xiaotianandbaihui-svg/Graduation_Design/README.md

.....正在做，未完结
- 10-21：只差一丢丢，就是主控板对于滚转的控制和辅助刹车的功能了。   跳跃功能，目前还需要实测，参数未填入。   磁力计当前无法确定电机转动是否会对imu产生严重影响。一切都需等待电路板到后组装观察。
- 10-22_day：出现严重控制逻辑错误。。  其实标准做法我个人认为存在正反馈风险，对于想要一次调试成功搞不好是机毁项目凉凉。。
电路板目前不支持电流闭环控制，无法做到精确的力矩控制，这主要是因为STM32F103的接口太少了，IO口全部用光了，当时的设计目标也并非面向电流环的，如果单电压环确定可以使用，那就好，不可以，会考虑双stm32f103或者直接换f407或者f429作为驱动主控。。  ε=(´ο｀*)))唉

- 10-22_night: 今天大改电路图和代码。代码部分要进行大面积修改。emm，电路图今晚出第二版 

- 10-23：代码重构了，但我还要审核，但是呢怎么说呢。。我总觉得有些地方很不对劲，目前也暂时不知道哪里不对劲。 板子再审计几遍，打板吧。嗨哟。服了
已经神志不清了

- 10-24：初版代码已经全部完成。等待板子到手，开始上机调试....不知道效果如何，我对跳跃部分还是很慌的。  板子目前看是舵机驱动板太小了，电机驱动板又大了，但是机械结构限制也无法交换。所以板子尺寸做了电机驱动二次压缩，舵机板强行拉大了

- 10-24-night：饿啊！调参调好了，还以为是算法的问题。。。

- 10-25/10-26/10-27：  校验代码... 裁剪冗余功能
- 10-27_night： 下位机校验完成，参数标记点已经做了，整体框架已经熟悉(AI做了很多的冗余设计，生怕把我电机和舵机烧了，这很好，因为学长打比赛的时候就是没做停机保护给电机烧了的，赛场上完蛋的！我也要注意！)  我做了校验，也看不出问题，调参实战吧。   现在工作中心来到上位机和无刷电机驱动原理(我希望有更加定量的力矩分析，不只是PID那种模糊的控制概念)
- 10-28-11-02： 测试硬件电路，舵机驱动板出现1V左右的电压波动，很严重。所以，换方案了。我打算四路独立供电，用LM2596S-ADJ了，成本也比现在的低。。。服了
- 11-03： 改了第二版和第三版舵机驱动，现在确定了第三版电路为最终驱动电路。单路最大达到3A，足够一个数字舵机使用，裕量达到堵转两倍多。 希望不要出问题，明天，板子交由AI仿真校验通过后打板。。
- 11-04：跳跃和PID的时钟分离，现在放弃严格尺寸，尽可能把板子做的小一些，所以有了第四版舵机驱动板
- 11-05： 硬件电路优化布线，舵机板改为四层板，因为他要承受的峰值电流是30A—+啊QAQ。。
  代码校验通过。周末去焊接板子，最近还在学FPGA和Linux，难受咯。。。
- 11-11：这几天测试板子，崩溃了，居然因为硬件问题卡死了。开尔文走线不合格导致ADC采样值频繁触发软件的过流保护。。。现在做出改版
