xiaotianandbaihui-svg/Graduation_Design/Remote_Controller/My_Remote_Controller/README_REMOTE.md

# 轮足机器人遥控器 V1

工程：`USER/RemoteController.uvprojx`，Keil target `TOUCH`。
硬件沿用原工程 STM32F407ZG、800×480 横屏、现有 LCD DMA 与触摸驱动。

## 使用方式

- 上电进入独立主界面，选择“自动运行”或“遥控模式”；两个模式页均提供“返回主界面”按钮。
- 遥控模式使用专门页面，同时显示**目标速度/偏航**和**实际速度/偏航**；速度单位m/s，角度单位度。不显示“REMOTE CONTROL”英文标题。
- 仅在遥控页进行10秒无数据检测。未收到新回传时实际值显示“--”；超时显示“无数据传回”，收到有效回传后自动恢复。进入遥控页重新计时，主界面/自动运行页不触发此检测。
- 遥控页采用深色蓝青仪表盘：左侧显示目标速度和目标偏航，中间为实际速度表盘，右侧为实际偏航角度盘。左下角保留160×160摇杆，右下角保留120×60跳跃按钮；不显示摇杆角度刻度和底部操作提示。
- 偏航盘用蓝色指示实际Yaw、橙色标记目标Yaw；0°朝上、+90°朝右，只表示小车姿态参考系，不表示地理北方。不显示尚未接入的GPS、电量、温度或时钟数据。
- 速度表盘下方绘制轮足机器人：实际速度显示为0.00 m/s时原地转圈，非零时用道路虚线流动表现行进，负速度时道路反向流动；等待回传或超时后动画停止并变暗。动画跟随回传的实际速度，使用现有50 ms界面刷新，不增加任务。
- 按住圆盘拖动：方向决定目标绝对 Yaw，离中心越远，目标速度越大。
- 默认上方 0°、右方 +90°、下方 ±180°、左方 −90°；Yaw 编码范围为 [−180°,180°)。
- 下拉表示朝 180°方向前进，不是负速度倒车。目标 Yaw 使用小车姿态解算的参考系，并不相对于遥控器朝向。
- 松手、失去按压或切换页面：摇杆回到中心，目标速度立即归零，保留最后的目标 Yaw。这里的“停止”是目标速度为零，小车实际减速由主控完成。
- 点击“跳跃”：速度先归零，在100ms周期帧中连续发3帧jump=1，随后发jump=0；按UART成功发送推进，不等待回传。主控按0→1边沿只触发一次。发送期间按钮禁用。
- “自动运行”页按要求留白，只保留“返回主界面”按钮。主界面和自动页不周期发送目标；离开遥控页仅尝试发送一次零速度、jump=0帧，随后停发。
- 当前触摸移植只使用第一个触点，不支持同时按住摇杆并点击跳跃。

## 接线与配置

沿用现有 **USART1，PA9=TX、PA10=RX，115200、8N1**。
PA9 接 LoRa RXD，PA10 接 LoRa TXD，两端共地；模块供电按其规格连接。
本版使用透明串口传输，不包含模块型号专属配置指令、M0/M1 控制或 AUX 流控。
两端 LoRa 应预先设置兼容的信道、空中速率和传输模式。

可调整宏集中在 `USER/remote_control.h`：

| 宏 | 默认值 | 含义 |
|---|---:|---|
| `REMOTE_UART_BAUD` | 115200 | 本地串口波特率，须匹配模块 |
| `REMOTE_SEND_PERIOD_MS` | 100 | 仅遥控页，由上位机时钟决定的目标帧间隔，回传不改变节拍 |
| `REMOTE_LORA_TIMEOUT_MS` | 10000 | 仅遥控模式下，无有效回传的掉线超时 |
| 主控 `SERIAL_LORA_TIMEOUT_MS` | 1000（当前工程） | 主控无有效目标帧的掉线超时；本次保持原值 |
| `REMOTE_WHEEL_DIAMETER_M` | 0.064 | 轮径，单位 m |
| `REMOTE_MAX_SPEED_MPS` | 1.0 | 摇杆拉满的目标速度；初次调试可调小 |
| `REMOTE_STICK_DEAD_ZONE` | 0.12 | 中心死区占最大行程的比例 |
| `REMOTE_YAW_SIGN` | +1 | 改为 −1 可反转左右对应的 Yaw 正负 |
| `REMOTE_YAW_OFFSET_DEG` | 0 | 摇杆正上方对应的绝对 Yaw |
| `REMOTE_JUMP_FRAMES` | 3 | 每次跳跃重复发送的请求帧数 |

死区取 [0,1)，跳跃重复次数取 1～254。改变 Yaw 方向/零点时，只需调整上述配置宏。
速度换算：`rpm = speed_mps × 60 / (π × 0.064)`，1 m/s 约为 298.42 rpm。

表盘量程单独配置在 `USER/remote_dashboard.h` 的 `REMOTE_DASHBOARD_SPEED_MAX_MPS`，默认1.0 m/s，按实际需求设为正数（建议至少0.1）。该宏只改变表盘显示量程，不改变控制目标或限速。实际速度超量程时弧形指示到顶、数字改为橙色，数字仍保留真实值；正负号也正常显示。

进入遥控页后，下一次LoRa任务轮询先发送一帧，随后每100ms发送最新目标速度、Yaw和跳跃位。
发送时钟来自上位机FreeRTOS tick；回传只更新实测值及掉线计时，丢失或迟到不会阻止下一周期发送。
松手和跳跃在下一周期帧生效，不另外插帧。退出遥控页只尝试发送一帧零速度、jump=0，然后停发；上电主界面、主界面与自动页之间切换均不发控制帧。
UART发送失败时，遥控页等待下一100ms周期重试最新目标，不连续补发；退出帧失败则显示串口错误，下位机仍由自己的接收超时机制停速。
LoRa任务每5ms轮询；任务阻塞会推迟实际发送，恢复后不连发补齐漏掉的周期。
UART波特率不等于LoRa空中速率；要在100ms内完成一轮无线收发，模块实际往返耗时必须小于100ms并留出裕量。此版无AUX流控和帧序号，不能严格匹配迟到回传，回传也不代表跳跃动作已经执行。

## 与主控一致的 8 字节协议

| 字节 | 内容 |
|---|---|
| 0～1 | `AA 55` |
| 2～3 | 有符号 int16，小端，目标 rpm × 10 |
| 4～5 | 有符号 int16，小端，目标 Yaw(°) × 100 |
| 6 | 跳跃：0 或 1 |
| 7 | 前 7 字节累加后取低 8 位 |

`AA 55 E8 03 28 23 00 35`：100 rpm、90°、不跳跃。
`AA 55 E8 03 28 23 01 36`：100 rpm、90°、请求跳跃。
这是协议示例；界面点击跳跃时实际发送零速度。

## 实测数据回传与超时

主控收到完整有效目标帧时，由串口中断更新 `Lora_LastRxCycles`，置全局 `Serial_ControlPending` 的bit0；bit1沿用跳跃请求标记。
主控正式分支（Formal=1）在主循环调用`Serial_ProcessControl()`：消费完整有效的新目标时返回1，随后`Serial_SendFeedback()`发送一帧实测数据；没有新目标只检查超时，不主动回传。

响应固定7字节，与下发的8字节目标帧区分：

| 字节 | 内容 |
|---|---|
| 0～1 | `55 AA` |
| 2～3 | 有符号int16，小端，实际平均轮速rpm × 10 |
| 4～5 | 有符号int16，小端，实际Yaw(°) × 100 |
| 6 | 前6字节累加后的低8位 |

例：`55 AA E8 03 28 23 35` 表示实际100 rpm、Yaw 90°。
平均轮速与主控速度PID一致：`(FOOT_WHEEL_SIGN_LEFT * Speed[0] + FOOT_WHEEL_SIGN_RIGHT * Speed[1]) / 2`。
该值是轮速估算的前进速度，未补偿轮胎打滑；遥控端按64 mm轮径换算为m/s。
主控回传最近一次解算的 `angle[1]` 和最近一次CAN轮速，不等待新的传感器采样，也不消耗CAN的PID就绪标志。

遥控端中断验证完整响应后置`Lora_RxPending`；独立LoRa任务中的`RemoteControl_Poll()`取走数据并更新显示，不改变100ms发送节拍。
`RemoteControl_GetFeedback()` 按值返回完整副本，包含 `speed_mps`、`yaw_deg`、`valid`、`timed_out`。
同样，`RemoteControl_GetCommand()` 改为按值返回，不再返回内部指针；例如 `RemoteFeedback actual = RemoteControl_GetFeedback();`。
`timed_out` 是界面使用的当前掉线状态，有效回传或换页后清零；`Lora_Timeout` 仍是供其他函数消费的锁存事件，收到数据不会自动清零。
`valid` 表示当前可显示实测值。每次进入遥控页先置为0，等待进入后的新回传；收到有效数据后置1，遥控模式掉线后置0。
尚未收到新数据或超时期间，不接受非零摇杆速度和新跳跃请求。遥控页以外也不接受遥控摇杆/跳跃输入。

两端分别提供同名全局量（属于两个独立固件）：

| 变量 | 作用 |
|---|---|
| `Lora_Timeout` | 达到本端配置的无有效数据超时阈值时置1；恢复收包不会自动清零，其他代码可读取后赋0 |
| `Lora_LastRxCycles` | 收到有效完整数据时记录DWT时刻；超时处理后也设为当前时刻，开始下一轮超时检查 |

遥控端只在遥控页进行10秒检查；到期后把目标速度归零、取消待发跳跃，并继续按100ms发送零速度探测恢复。主控按自己的`SERIAL_LORA_TIMEOUT_MS`检测（当前1000ms），到期后把`target_Speed`及未执行的`Jump_Request`清零。
两端保留目标Yaw。连续离线时，各自按配置的超时间隔重新置位；其他代码清掉超时标志不会使运动自动恢复。
时间判断采用 `(uint32_t)(now - last)`，支持DWT自然回绕，不清零DWT计数器；两端主循环必须持续执行。
72 MHz时DWT约59.65秒回绕，168 MHz时约25.57秒回绕，当前10秒阈值均适用。不能停止轮询超过一个回绕周期，也不把调试暂停/深睡眠算入正常在线计时。
半帧、校验错误、串口错误和普通调试文本均不刷新有效收包时间。完整数据只在短临界区内交接，发送与浮点换算在中断外执行。

`printf/fputc` 保留。完整控制帧发送时暂停任务切换，防止其他任务的日志字节插进帧中；中断仍能响应。
不要在 ISR 中 printf。日志与控制帧共用串口，会占用 LoRa 带宽，不宜高频刷屏。
“串口发送失败”表示本机UART发送失败；UART发送成功不代表无线对端确认收到。实测回传用于确认有数据返回，不再用于放行下一次发送。
无线丢包时无法保证跳跃必达；切页也不能撤销对端已接收的跳跃。

## 文件职责与改动

| 文件 | 改动 |
|---|---|
| `USER/remote_control.c/.h`（新增） | 摇杆换算、64 mm 轮径换算、控制帧打包、发送/响应、回传解码、DWT掉线检测、跳跃脉冲 |
| `USER/remote_ui.c/.h` | 主界面、独立遥控页、自动运行页、圆盘触控、跳跃按钮、页面扩展入口；遥控数据显示交给仪表盘组件 |
| `USER/remote_dashboard.c/.h`（新增） | 目标/实际数据显示、速度表盘、偏航角度盘、回传状态和轮足机器人动画；原生LVGL绘制，无图片帧缓存 |
| `USER/remote_font.c/.h` | 中文/ASCII 20px、24px字形子集，以及48px、72px纯数字字形，减少字体占用 |
| `USER/main.c` | 初始化硬件和共享数据，调用统一任务创建入口，然后启动调度器 |
| `USER/app_tasks.c/.h` | 集中放GUI/LoRa任务函数、按表创建任务的函数及tick hook |
| `USER/task_config.c/.h` | 独立声明任务配置结构体，定义任务配置表和表长度 |
| `SYSTEM/usart/usart.c/.h` | 新增完整二进制帧发送和超时；保留 printf；接收中断移除不适用的任务临界区调用，接收中断解析并缓存LoRa实测回传 |
| `SYSTEM/delay/delay.c` | 恢复 SysTick HCLK/8 轮询阻塞延时；任务中挂起调度，退出配对恢复；累计回绕并分段避免乘法溢出 |
| `FreeRTOS/FreeRTOSConfig.h` | 保持 SysTick HCLK/8 和 1 ms tick；开启 tick hook，并允许查询调度器状态 |
| `MIDDLEWARE/LVGL/GUI/lvgl/lv_conf.h` | 使用 lv_tick_inc；本次保持配置不变，仪表盘使用专用数字字体子集 |
| `MIDDLEWARE/LVGL/GUI/lvgl/examples/porting/lv_port_disp_template.c` | 双绘图缓冲由各 20 行缩为各 10 行，节省约 32 KB RAM；修正 static 声明 |
| 同目录 `lv_port_disp_template.h`、`lv_port_indev_template.h` | 启用模板中被 `#if 0` 屏蔽的接口声明 |
| `USER/RemoteController.uvprojx` | 加入新文件，FreeRTOS 引用改为工程内已有副本 |

`delay_init()` 只在调度器启动前调用，启动前不打开 SysTick 中断；FreeRTOS启动后接管为 1 ms 中断，继续使用同一八分频时钟。
`delay_us()` / `delay_ms()` 均为阻塞忙等，LCD、触摸、软件 I²C 等现有调用继续使用。
延时过程中中断仍可响应；不要从ISR调用，也不要在调用期间改变SysTick配置。中断占用时间会影响延时精度。
`delay_ms(u16)` 最大参数为65535 ms；更长时间可分次调用，或用 `delay_us(u32)`，例如 `delay_us(120000000u)` 为至少120 s的忙等。
串口20ms发送超时及LoRa掉线检测使用DWT，由`uart_init()`独立启用；100ms发送节拍使用FreeRTOS tick；`printf`保留。
GUI主循环的 `vTaskDelay(5 ms)` 负责让出CPU，继续保留，不用于外设微秒时序。

两个应用任务分别运行，函数集中在 `app_tasks.c`；配置集中在 `task_config.c`，结构体声明在 `task_config.h`：

| 任务 | 函数 | 栈大小 | 优先级 | 间隔 | 职责 |
|---|---|---:|---:|---:|---|
| GUI | `App_GuiTask` | 2048字=8KB | 2 | 每轮结束等待5 ms | 初始化显示/触摸、处理LVGL、显示目标/回传/状态 |
| LoRa | `App_LoraTask` | 512字=2KB | 3 | 每5 ms轮询 | 遥控页100ms周期发送、回传处理、退出单帧停速及遥控页10秒掉线检测 |

FreeRTOS还会创建自身的Idle任务。配置表统一保存名称、入口函数指针、栈深度、优先级、间隔和任务句柄；任务参数自动传入对应表项的地址。
栈深度单位是 `StackType_t`，本机每字4字节；优先级数字越大越高，须小于 `configMAX_PRIORITIES`。间隔必须至少1个tick。
新增任务时，在 `app_tasks.c/.h` 添加函数/声明，在 `task_config.c` 增加一行即可；创建循环按表长度自动处理。
GUI读取共享数据时获取完整副本；修改目标及协议状态时短暂暂停任务切换，UART接收中断仍能响应。LoRa任务不调用LVGL，UART发送结果只通过一个对齐标量交给GUI显示。
LoRa任务使用FreeRTOS tick独立计时，不依赖LVGL刷新。tick hook只调用允许在中断使用的 `lv_tick_inc`；LCD DMA中断仍只通知刷新完成。
原SysTick阻塞延时、UART整帧发送保护及printf均保留：这些既有函数中的调度暂停仍会暂时推迟任务切换，拆成多任务不消除这部分延迟。
新增页面：在 `remote_ui.h` 扩展 `RemotePage`，在 `remote_ui.c` 增加创建函数并加入 `page_create` 表，再用 `RemoteUi_ShowPage()` 切换。

## 验证与联调事项

已在电脑上使用本工程真实 LVGL 源码绘制并检查三个页面，模拟拖动、越界拖动、松手、跳跃、换页和串口失败提示。
控制逻辑测试覆盖完整 360°方向、死区、速度换算、字节格式、发送时钟回绕和失败重试。
也用主控当前的 `Hardware/Serial.c` 验证了解码兼容性。
Keil 完整重编译：0 Error、30 Warning；30 条警告均位于原有 LVGL 库，本次应用代码没有编译警告。
原版链接 RAM 占用约 95.3 KiB，位于 128 KiB SRAM 范围内；当前布局的具体占用以本次 Keil 构建输出为准。
固件生成于 `OBJ/TOUCH.hex`。这些检查不代替实板触摸、LCD DMA 和无线链路测试。

本次两端互传验证覆盖：实际编解码互通、正负轮速/Yaw、半帧/错包/调试文字、UART错误、等待响应时不连发、丢响应重试最新目标、跳跃重试不重复触发、10秒边界与重复超时、72/168 MHz下DWT回绕及恢复连接。两端printf后端保持原样。

主控当前仍为 `Formal == 2` 调试分支：CAN初始化被注释，轮速回传因此为初始值；高频姿态printf也仍保留。正式无线联调时，需要使用已开启CAN轮速反馈的运行配置，并避免调试日志持续占满同一LoRa串口。跳跃暂停CAN时，回传轮速为暂停前最近一帧，不是新的轮速采样。
Keil检查：主控正式分支0错误0警告，调试分支0错误3个原有未使用函数警告；遥控端0错误30个原有LVGL警告。尚未进行实物LoRa联调。

## 2026-10-30 多任务与回传显示验证

已验证配置表创建/失败路径、GUI与通信任务职责、共享数据副本与嵌套调度保护；原LoRa协议、跳跃重试和DWT回绕测试继续通过。
使用工程真实LVGL进行界面绘制和触摸模拟，覆盖主界面/自动页不报10秒超时、遥控页重计时、实测正负值及极值不越界、无数据提示、外部清除事件标志不掩盖当前掉线、恢复回传及页面切换。
Keil完整重编译0错误，30条警告仍来自原LVGL库；新增应用代码无编译警告。尚未进行实板任务栈余量与LoRa联调。

## 2026-10-30 仪表盘与机器人动画

使用工程真实LVGL源码在电脑上绘制检查，验证目标/实际正负数、超量程数字、原地旋转、行进道路流动、无数据时动画停止，以及摇杆松手回中、跳跃、换页、仅遥控模式超时与恢复。
本次只改界面组件、字体、工程文件列表和本说明；LoRa协议、两任务配置、阻塞延时与printf保持原样。电脑渲染预览并非实板录像，实板刷新速度与触摸体验仍需烧录验证。

## 2026-11-04 遥控页100ms主动发送

本节和上文当前用法取代旧验证记录中的“等响应/500ms重试”流程。
仅修改USER/remote_control.c、USER/remote_control.h及本说明。沿用现有界面切页接口、任务配置、8字节目标/7字节回传协议和printf。
主控当前选择Formal=4串口调试分支，未执行完整收包后的正常回传调用；正式联调须选择Formal=1或由用户在调试流程中接入该调用。本次没有切换主控运行分支，也没有修改主控源文件。
主机测试通过：非遥控页静默、无/迟到响应不改变100ms发送、松手与跳跃在周期帧生效、退出单帧停速、UART失败限速重试、与当前主控Serial.c编解码互通、10秒超时、毫秒/DWT回绕及任务切换。
遥控工程完整编译0错误，30条警告均来自原有LVGL代码。尚未实测LoRa空中往返时间。
