xiaotianandbaihui-svg/Graduation_Design/固件代码(非KEIL工程)/BDS3620_TLE5012B_六步换相/验证记录.md

# 验证记录

日期：2026-10-01。目标：STM32F103C8T6，STM32F10x标准库，Cortex-M3，64KB Flash / 20KB RAM。

## 软件逻辑测试

执行 `tests/validate.ps1`，主机GCC采用 `-std=c99 -O2 -Wall -Wextra -Werror` 编译 `motor.c`、`tle5012b.c` 和模拟硬件测试。

结果：全部断言通过。

```text
PASS: CRC/status; 65536 signed-angle cases; 42 sectors/rev; dual-motor stop/faults; timing/wrap; calibration +/- and stalled rotor.
```

覆盖内容：

- CRC-8/SAE-J1850标准测试字符串`123456789`，结果0x4B；数据损坏和安全字错误检查。
- 编码器正、反两个方向，每个方向遍历全部32768个角度计数。
- 每机械圈42次扇区变化；正反向矢量相差180电角度；正向矢量领先60～120电角度。
- 编码器高位屏蔽、角度比例、跨机械零点、DWT计数器回绕。
- 未标定拒绝启动、双路运行、单路停止、故障时双路关闭、故障恢复后不自动启动。
- CRC错误、总线错误、运行超时、模拟驱动器故障和持续复位状态。
- 两种编码器方向的模拟标定成功，以及模拟转子不动时标定失败。

这里模拟了硬件端口、时间推进和电机对齐响应，**没有模拟真实绕组电流、磁场误差或MOS开关动态**。硬件定时器和中断的真实波形不由这些主机测试证明。

## ARM标准库编译与链接

工具：MDK Plus 5.39，Arm Compiler for Embedded 6.21。

依赖：Keil STM32F1xx_DFP 2.4.1中的设备头文件、STM32F10x SPL源文件、系统时钟源文件和中容量启动文件；CMSIS 5.9.0。

本例4个C源文件及所需标准库源文件使用Cortex-M3目标、`-O2 -Wall -Wextra -Werror`编译。分别链接默认只读角度分支和启用标定/运行分支，均通过。

| 示例 | 链接器报告的ROM | RW+ZI，含启动文件预留堆栈 | 结果 |
|---|---:|---:|---|
| 默认只读角度 | 8892字节 | 1728字节 | 通过 |
| 启用标定和运行分支 | 10348字节 | 1736字节 | 通过 |

链接布局限制为64KB Flash、20KB RAM。上表是本示例独立构建的数值，不包含你原工程的其他模块，也不等于对运行时最大调用栈的实测。

C代码编译没有警告。Keil自带启动汇编文件构建时出现一条工具提示：`A1950W: The legacy armasm assembler is deprecated`；它提示汇编工具已弃用，不是固件代码错误。两次链接成功。

最终构建输出位于本机临时目录：

`C:/Users/lenovo/AppData/Local/Temp/bds3620_validate_8c60713967fb43baa3d1564ffb9ef83c`

其中 `motor.map`、`motor_with_calibration.map` 是对应链接报告。脚本可重现构建；无需依赖临时目录长期存在。未执行烧录。

## 尚未实测

- 成品编码器板的电平和MOSI/MISO内部接法、双模块总线释放行为。
- SPI时序与CRC在实物上的连续读取、实际程序执行时间。
- 三相接线、门极切换波形、对齐占空比和电流、最大可运行转速。
- 板上nFAULT触发、更新超时处理与实际功率级停止行为。

因此交付状态为：**源码、编译链接和软件逻辑测试完成，硬件实测未完成。**
