xiaotianandbaihui-svg/Graduation_Design/固件代码(非KEIL工程)/LQR准备--状态方程/LQR计算/使用说明.md

打开 `run_wheel_leg_lqr.m`，把NaN替换为实际机械参数，填写Q、R后运行，即可显示K。

这是独立脚本，只调用MATLAB的lqr（需要Control System Toolbox），不依赖其他自定义函数。计算连续时间LQR，状态顺序为[位移、速度、倾角、倾角速度]，角度使用弧度；输入tau=-K*X是两轮力矩之和，单位N*m。
