xiaotianandbaihui-svg/Graduation_Design/Remote_Controller/APB_BUS_Learn/image.png

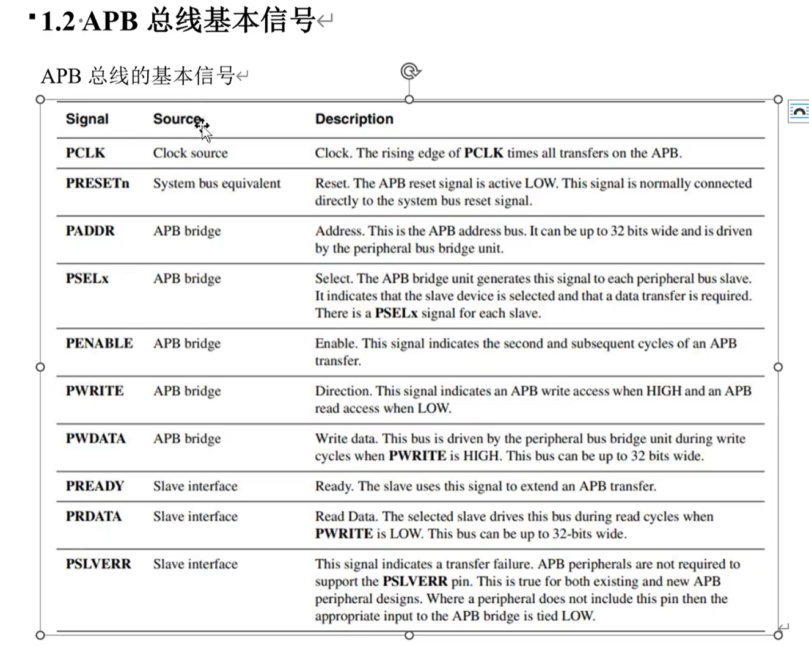
Remote_Controller/APB_BUS_Learn/image.png
