xiaotianandbaihui-svg/Graduation_Design/固件代码(非KEIL工程)/LQR准备--状态方程/image.png

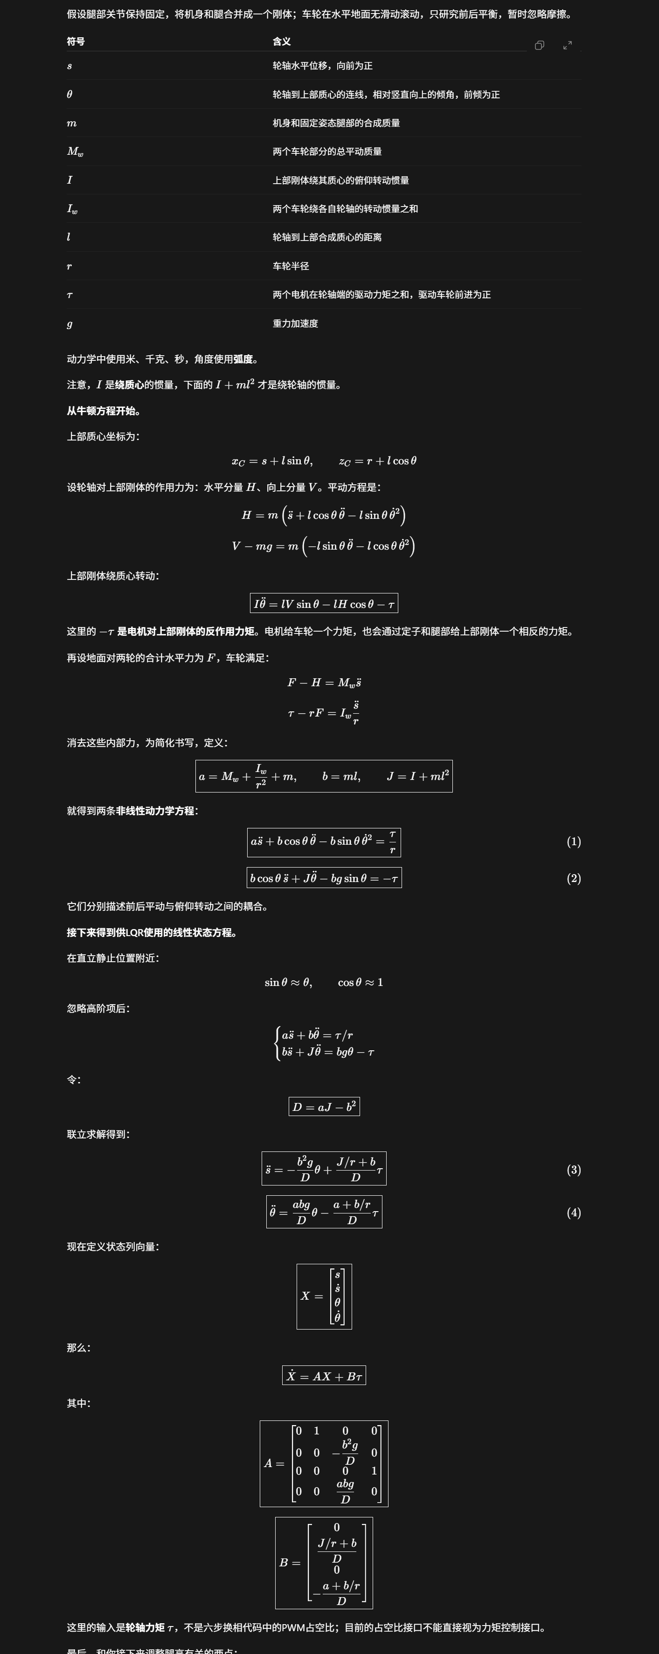
固件代码(非KEIL工程)/LQR准备--状态方程/image.png
