xiaotianandbaihui-svg/Graduation_Design/固件代码(非KEIL工程)/五连杆逆运动学/两根连杆_两种姿态.png

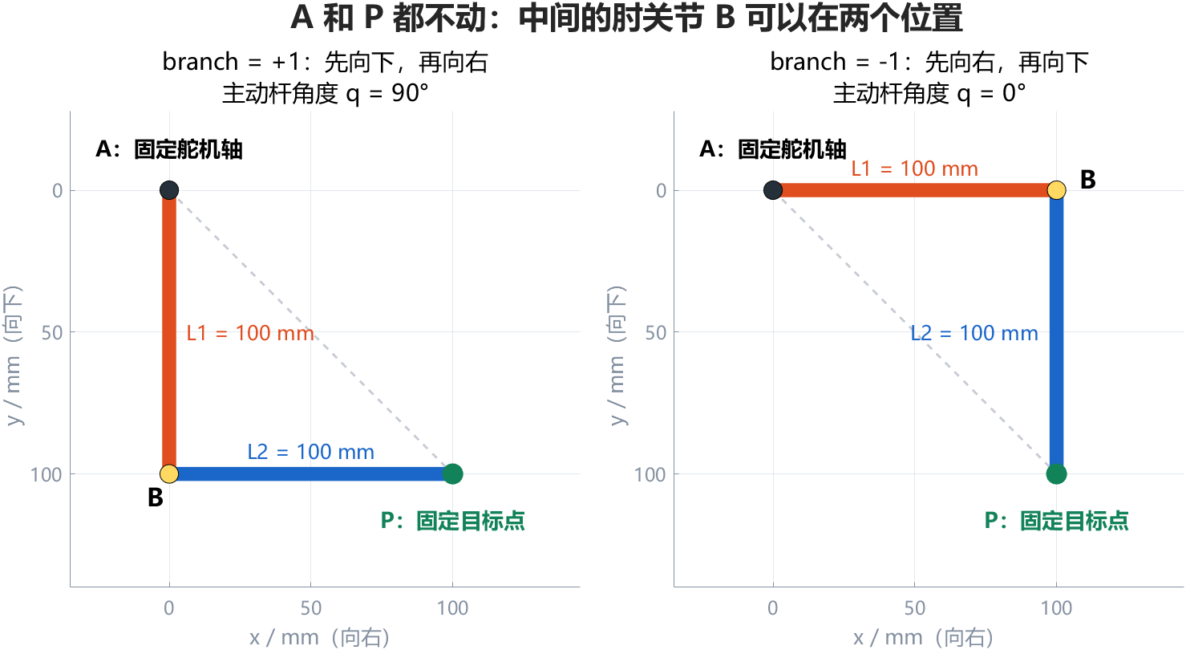
固件代码(非KEIL工程)/五连杆逆运动学/两根连杆_两种姿态.png
