xiaotianandbaihui-svg/Graduation_Design/固件代码(非KEIL工程)/五连杆逆运动学/五连杆_branch1对比.png

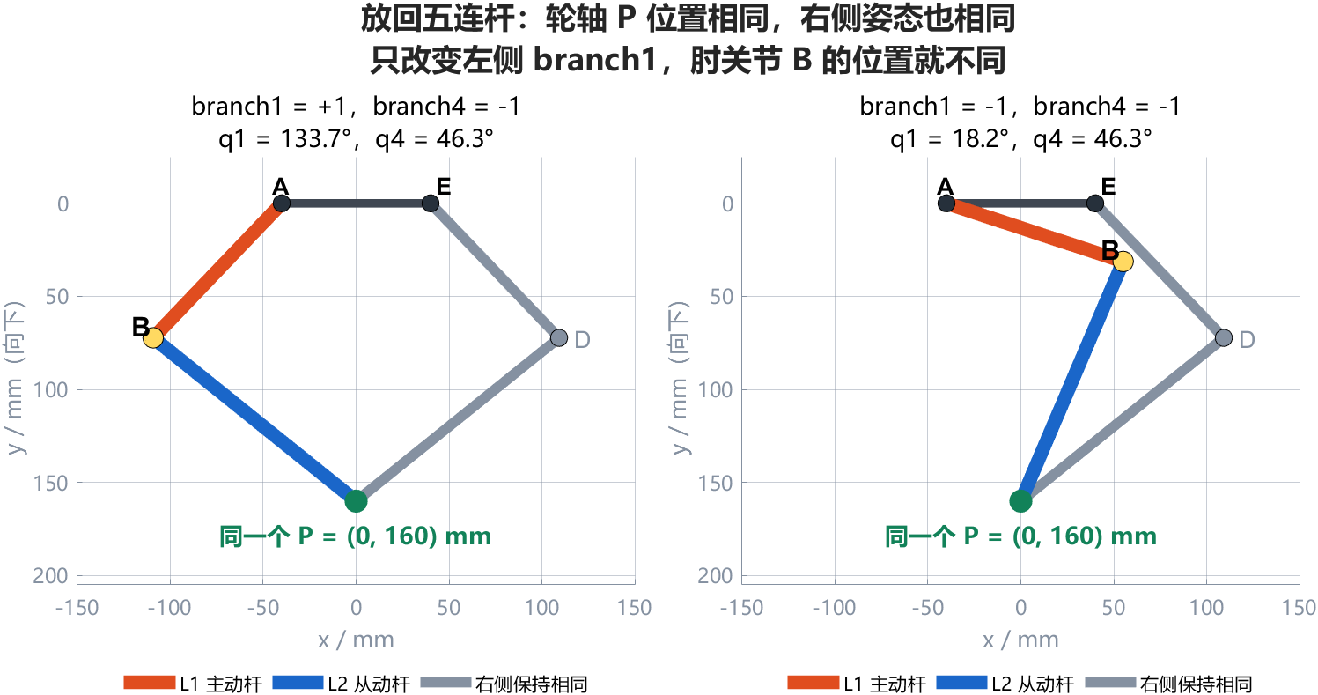
固件代码(非KEIL工程)/五连杆逆运动学/五连杆_branch1对比.png
