xiaotianandbaihui-svg/Graduation_Design/电机驱动BOM(器件可以找相似平替).xlsx

No. | Quantity | Comment | Designator | Footprint | Value | Manufacturer Part | Manufacturer | Supplier Part | Supplier
1 | 2 | 1uF/25V | C1,C20 | C0805 | 1uF/25V | CL21B105KBFNNNE | SAMSUNG(三星) |  | LCSC
2 | 1 | 10uF | C2 | C0603 |  | 10uF |  | C9900012833 | LCSC
3 | 1 | 0.1uF | C3 | C0603 |  | 0.1uF |  | C9900012833 | LCSC
4 | 5 | 100nF | C4,C23,C24,C25,C27 | C0805 | 100nF | CL21B104KBCNNWC | SAMSUNG(三星) | C3901446 | LCSC
5 | 5 | 0.1uF/25V | C5,C11,C14,C15,C28 | C0603 |  | 0.1uF/25V |  | C9900012833 | LCSC
6 | 2 | >10uF/25V | C6,C8 | C0603 |  | >10uF/25V |  | C9900012833 | LCSC
7 | 2 | 1uF/10V | C9,C10 | C0603 |  | 1uF/10V |  | C9900012833 | LCSC
8 | 2 | 100nF | C12,C13 | C0603 | 100nF | ST18B104K500CT | Walsin(华新科) | C2918557 | LCSC
9 | 1 | 47nF | C16 | C0805 | 47nF | C0805C473K2RAC7800 | KEMET(基美) | C141149 | LCSC
10 | 2 | 22pF | C17,C26 | C0603 | 22pF | C0603C220J2GAC7867 | KEMET(基美) | C140958 | LCSC
11 | 2 | 47nF/50V | C21,C22 | C0402 | 47nF/50V | 0402X473K250NT | FH(风华) |  | LCSC
12 | 1 | HDR1X2 | CAN | HDR-TH_2P-P2.54-V-M-1 |  | HDR1X2 |  | C9900014921 | LCSC
13 | 13 | CSD18540Q5BT | Q1,Q2,Q3,Q4,Q5,Q6,Q7,Q8,Q9,Q10,Q11,Q12,Q13 | PDFNWB-8L_L6.0-W5.0-P1.27-BL-EP |  | CSD18540Q5BT | TI(德州仪器) | C2863985 | LCSC
14 | 2 | 75kΩ | R1,R2 | R0603 | 75kΩ | ERJ3GEYJ753V | PANASONIC(松下) | C403533 | LCSC
15 | 6 | 10kΩ | R3,R4,R6,R10,R11,R13 | R0204 | 10kΩ | MELF-MFR02041/4WS10KΩFT50 | Thunder Component(帝谷) | C265133 | LCSC
16 | 1 | 1kΩ | R5 | R1206 | 1kΩ | MELF-MFR02041/4WS1KΩFT50 | Thunder Component(帝谷) | C265216 | LCSC
17 | 2 | 100kΩ | R7,R8 | R0402 | 100kΩ | RE0402FRE07100KL | YAGEO(国巨) | C852071 | LCSC
18 | 2 | 60Ω | R9,R12 | R0402 | 60Ω | M55342H11B60D0RWI | VISHAY(威世) | C4323948 | LCSC
19 | 2 | 47kΩ/0Ω | R15,R16 | R0603 | 47kΩ/0Ω | CR0603JA0473G | LIZ(丽智电子) |  | LCSC
20 | 2 | XH2.54-4PIN | STLink,串口调试接口 | CONN-TH_XH2.54-4 |  | XH2.54-4PIN |  | C9900014913 | LCSC
21 | 2 | DRV8323HRTAT | U1,U2 | WQFN-40_L6.0-W6.0-P0.50-TL-EP4.2 |  | DRV8323HRTAT | TI(德州仪器) | C2150673 | LCSC
22 | 1 | LM7805-5V | U3 | TO-252-3L_L6.6-W6.1-P4.60-LS9.5-BR-CW |  | LM7805-5V |  | C9900015885 | LCSC
23 | 1 | 220nF/25V | U4 | C1206 | 220nF/25V | CA45A-A-35V-0.22UF-K | XY(振华新云) |  | LCSC
24 | 1 | AMS1117-3.3 | U5 | SOT-223-3_L6.5-W3.4-P2.30-LS7.0-BR |  | AMS1117-3.3 | Advanced Monolithic Systems | C6186 | LCSC
25 | 2 | 220uF | U6,U7 | CAP-SMD_BD6.3-L6.6-W6.6-LS7.2-FD-1 |  | 220uF |  | C9900014617 | LCSC
26 | 1 | STM32F103C8T6 | U8 | LQFP-48_L7.0-W7.0-P0.50-LS9.0-BL |  | STM32F103C8T6 | ST(意法半导体) | C8734 | LCSC
27 | 6 | 5mΩ | U9,U10,U11,U12,U13,U14 | R1206 | 5mΩ | ZLR06-1-5F | yezhan(业展) | C5200077 | LCSC
28 | 1 | SS12D00G2 | U15 | SW-TH_SS12D00G2 |  | SS12D00G2 | YIZHI(逸致) | C50377146 | LCSC
29 | 1 | 电源灯 | U16 | LED0805-RD_GREEN |  | 电源灯 |  | C9900005753 | LCSC
30 | 1 | TJA1050T | U18 | SOIC-8_L4.9-W3.9-P1.27-LS6.0-BL |  | TJA1050T | NXP(恩智浦) | C23069945 | LCSC
31 | 1 | 3.81_2P接线端子 | U19 | CONN-TH_3.81_2P |  | 3.81_2P接线端子 |  | C2895155 | LCSC
32 | 1 | 8MHz | X1 | CRYSTAL-SMD_L3.2-W2.5_3225-8MHZ | 8MHz | X22EL89COI-111YLC-8M | YXC(扬兴晶振) | C42448903 | LCSC
33 | 1 | SW_PB_ESW_1 | 复位 | KEY-SMD_L6.1-W3.8-LS8.0 |  | SW_PB_ESW_1 |  | C9900009156 | LCSC
34 | 2 | ZH1.5-WF-6P | 编码器1,编码器2 | CONN-SMD_6P-P1.50_XUNPU_WAFER-ZH1.5-6PWB |  | ZH1.5-WF-6P |  | C9900021899 | LCSC
