xiaotianandbaihui-svg/Graduation_Design/舵机驱动BOM((器件可以找相似平替)).xlsx

No. | Quantity | Comment | Designator | Footprint | Value | Manufacturer Part | Manufacturer | Supplier Part | Supplier
1 | 1 | 6.8nF/50V | C1 | C0603 | 6.8nF/50V | C1608X8R2A682K080AE | TDK |  | LCSC
2 | 1 | 330nF/50V | C2 | C0402 | 330nF/50V | CL05B103KO5NNWC | SAMSUNG(三星) |  | LCSC
3 | 1 | 680pF/50V | C3 | C0402 | 680pF/50V | UMK105CH750JV-F | TAIYO YUDEN(太诱) |  | LCSC
4 | 1 | 220nF/16V/陶瓷 | C4 | C0603 | 220nF/16V/陶瓷 | CC0603KRX7R9BB104 | YAGEO(国巨) |  | LCSC
5 | 1 | 220nF/16V/陶瓷 | C5 | C0805 | 220nF/16V/陶瓷 | CC0805KRX7R9BB221 | YAGEO(国巨) |  | LCSC
6 | 1 | 2.2uF/16V/陶瓷 | C6 | C0805 | 2.2uF/16V/陶瓷 | CC0805KRX7R9BB221 | YAGEO(国巨) |  | LCSC
7 | 1 | 22pF/50V | C7 | C0402 | 22pF/50V | GCM1555C1H820JA16J | muRata(村田) |  | LCSC
8 | 6 | 22uF/25V/陶瓷 | C8,C9,C10,C11,C13,C14 | C0805 | 22uF/25V/陶瓷 | CC0805KRX7R9BB221 | YAGEO(国巨) |  | LCSC
9 | 2 | 100nF | C12,C15 | C0805 | 100nF | CC0805KRX7R9BB104 | YAGEO(国巨) | C49678 | LCSC
10 | 1 | LAIL-PZ2.54-4P-L | H1 | CONN-TH_LAIL-PZ2.54-4P-L |  | LAIL-PZ2.54-4P-L | LAILAN(莱联) | C54950602 | LCSC
11 | 1 | 6.8uH/14A对应20℃温升；18.5A对应40℃温升 | L1 | IND-SMD_L11.3-W10.0_XAL1010-332ME | 6.8uH/14A对应20℃温升；18.5A对应40℃温升 | XAL1010-682MED | Coilcraft(线艺) |  | LCSC
12 | 3 | CSD18540Q5BT | Q1,Q2,Q3 | PDFNWB-8L_L6.0-W5.0-P1.27-BL-EP |  | CSD18540Q5BT | TI(德州仪器) | C2863985 | LCSC
13 | 1 | 16.5kΩ | R1 | R0805 | 16.5kΩ | AC0805FR-0716K5L | YAGEO(国巨) | C228333 | LCSC
14 | 1 | 680Ω | R2 | R0805 | 680Ω | WR08X681 JTL |  | C384073 | LCSC
15 | 1 | 2K | R3 | R0603 | 2K
16 | 1 | 1.5kΩ | R4 | R0603 | 1.5kΩ | RN731JTTD1502B25 | KOA |  | LCSC
17 | 1 | 33.2kΩ | R5 | R0402 | 33.2kΩ | PTFR0402B33K2N9 | RESI(开步睿思) | C2692992 | LCSC
18 | 1 | 1kΩ | R6 | R0805 | 1kΩ | ESR10EZPF71R5 | ROHM(罗姆) |  | LCSC
19 | 2 | 4.7Ω | R7,R8 | R0805 | 4.7Ω | CR0805F84R70G | LIZ(丽智电子) | C101766 | LCSC
20 | 1 | 10mΩ | R10 | R1206 | 10mΩ | RE1206F1R010 | JIERR(捷而瑞) | C46961737 | LCSC
21 | 1 | LM5146RGYR | U1 | VQFN-20_L4.5-W3.5-P0.50-BL-EP |  | LM5146RGYR | TI(德州仪器) | C3188679 | LCSC
22 | 1 | 7.68kΩ | U2 | R0603 | 7.68kΩ | ERA-3AEB7681V | PANASONIC(松下) | C2074630 | LCSC
23 | 1 | 49.9kΩ | U3 | R1206 | 49.9kΩ | CR1206F44992G | LIZ(丽智电子) | C102209 | LCSC
24 | 1 | 20kΩ | U4 | R0603 | 20kΩ | MCR03ERTF2002 |  | C224673 | LCSC
25 | 1 | SS12D00G2 | U5 | SW-TH_SS12D00G2 |  | SS12D00G2 | YIZHI(逸致) | C50377146 | LCSC
26 | 3 | 3.81_2P接线端子 | U6,U7,U19 | CONN-TH_3.81_2P |  | 3.81_2P接线端子 |  | C2895155 | LCSC
27 | 4 | TXM_3 | U8,U9,U10,U11 | HDR-TH_3P-P2.54-V-M-A |  | TXM_3 |  | C9900014923 | LCSC
28 | 1 | 220uF/25V-SMT | U12 | CAP-SMD_BD8.0-L8.3-W8.3-LS9.3-FD-1 |  | 220uF/25V-SMT |  | C9900017672 | LCSC
29 | 2 | 100kΩ | U13,U16 | R0603 | 100kΩ | MCR03ERTF2002 |  |  | LCSC
30 | 2 | 16V470UF | U14,U15 | CAP-SMD_BD8.0-L8.3-W8.3-LS9.3-FD |  | 16V470UF |  | C9900014916 | LCSC
