xiaotianandbaihui-svg/Graduation_Design/电机驱动4.0.xlsx

No. | Quantity | Comment | Designator | Footprint | Value | Manufacturer Part | Manufacturer | Supplier Part | Supplier
1 | 8 | 0.1uF/25V | C1,C4,C10,C11,C17,C18,C23,C28 | C0603 |  | 0.1uF/25V |  | C9900012833 | LCSC
2 | 8 | 22uF/25V/陶瓷 | C2,C5,C9,C12,C13,C16,C19,C22 | C0805 | 22uF/25V/陶瓷 | CC0805KRX7R9BB221 | YAGEO(国巨) |  | LCSC
3 | 8 | 10uF | C3,C6,C7,C8,C14,C15,C20,C21 | C0603 |  | 10uF |  | C9900012833 | LCSC
4 | 1 | LAIL-PZ2.54-4P-L | H1 | CONN-TH_LAIL-PZ2.54-4P-L |  | LAIL-PZ2.54-4P-L | LAILAN(莱联) | C54950602 | LCSC
5 | 1 | CSD18540Q5BT | Q3 | PDFNWB-8L_L6.0-W5.0-P1.27-BL-EP |  | CSD18540Q5BT | TI(德州仪器) | C2863985 | LCSC
6 | 4 | 8.2kΩ | R1,R4,R7,R10 | R0805 | 8.2kΩ | HPCR0805F8K20K9 | RESI(开步睿思) | C365352 | LCSC
7 | 4 | 49.9Ω | R2,R5,R8,R11 | R0603 | 49.9Ω | RNCS0603BKE49R9 | SEI(Stackpole Electronics Inc.) | C346679 | LCSC
8 | 4 | 560Ω | R3,R6,R9,R12 | R0805 | 560Ω | CR0805F85600G | LIZ(丽智电子) | C101789 | LCSC
9 | 4 | TPS54302DDCR | U1,U4,U11,U21 | TSOT-23-6_L2.9-W1.6-P0.95-LS2.8-BR |  | TPS54302DDCR |  | C316459 | LCSC
10 | 4 | 82pF | U2,U8,U12,U22 | C0603 | 82pF | 06035A820J4T2A | Kyocera AVX | C2182739 | LCSC
11 | 4 | 10uH | U3,U9,U14,U23 | IND-SMD_L5.7-W5.1 |  | 10uH |  | C9900015114 | LCSC
12 | 1 | SS12D00G2 | U5 | SW-TH_SS12D00G2 |  | SS12D00G2 | YIZHI(逸致) | C50377146 | LCSC
13 | 4 | 100kΩ | U10,U13,U15,U24 | R0603 | 100kΩ | MCR03ERTF2002 |  |  | LCSC
14 | 4 | TXM_3 | U16,U17,U18,U20 | HDR-TH_3P-P2.54-V-M-A |  | TXM_3 |  | C9900014923 | LCSC
15 | 3 | 3.81_2P接线端子 | 主控供电,电驱供电,舵机供电 | CONN-TH_3.81_2P |  | 3.81_2P接线端子 |  | C2895155 | LCSC
