xiaotianandbaihui-svg/Graduation_Design/Motor_Board.SLDPRT

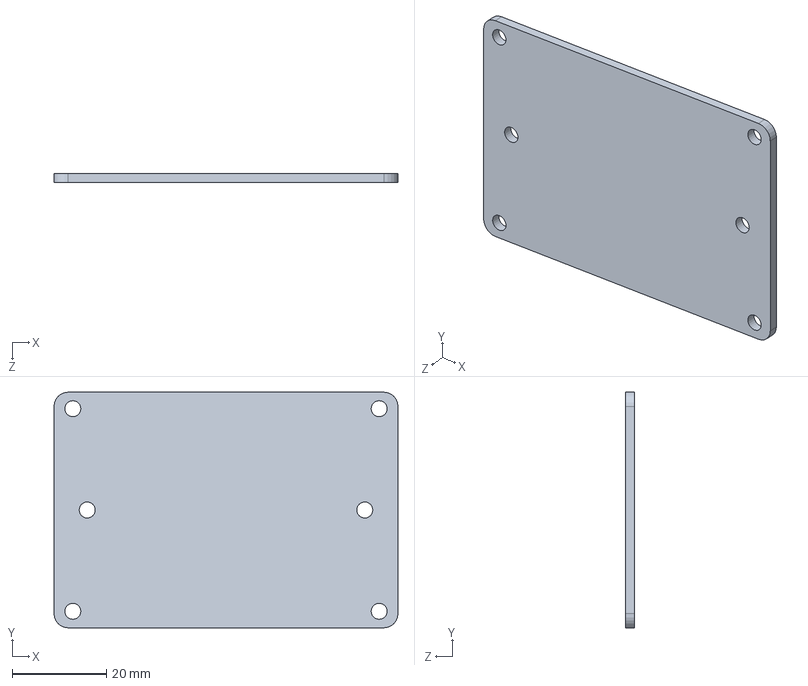
[picture p6: CAD file, 2026-11-01]
Motor_Board.SLDPRT
73.0 x 50.0 x 2.00 mm
