xiaotianandbaihui-svg/Graduation_Design/Battery_Room.SLDPRT

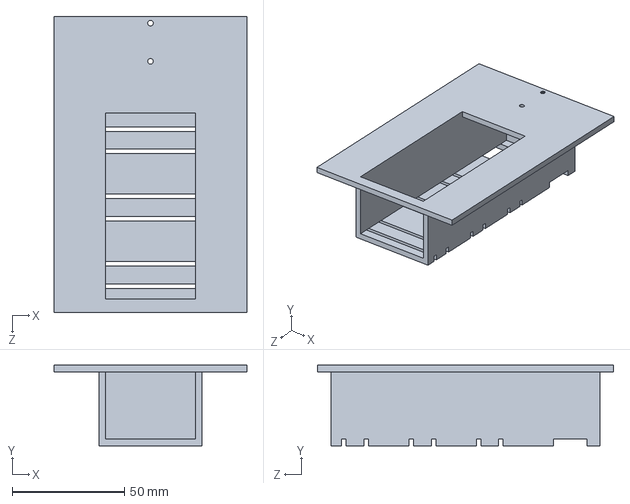
[picture p7: CAD file, 2026-10-14]
Battery_Room.SLDPRT
86.0 x 36.0 x 132.0 mm
