xiaotianandbaihui-svg/Graduation_Design/(list of files, cad)

Other CAD files:
Motor_Board.STL
