xiaotianandbaihui-svg/Graduation_Design/Central_Controller_KEIL/User/main.c

#include "stm32f10x.h"
#include "Serial.h"
#include "mpu6500_spi.h"
#include <stdio.h>
#include <math.h>
#include "can_pitch.h"
#include "zf_device_imu963ra.h"
#include "IMU.h"
#include "leg_ik.h"
#include "servo.h"
#include "Delay.h"
#include "balance_pid.h"
#include "jump.h"

#define IMU_PERIOD_MS  1u       /* TIM2时基，单位ms */
#define IMU_ATTITUDE_PERIOD_MS 20u /* 完整姿态采样/解算周期，独立于FOOT_PID_PERIOD_MS，这里我们只是给的一样，但是完全可以不一样 */
#define IMU_CYCLE_NOW (*(volatile uint32_t *)0xE0001004u) /* DWT周期计数，不清零 */
#if FOOT_PID_PERIOD_MS < 1u || IMU_ATTITUDE_PERIOD_MS < 1u
#error Control_period_must_be_positive
#endif

#if IMU_PERIOD_MS < 1u || IMU_PERIOD_MS > 50u
#error IMU_PERIOD_MS_must_be_1_to_50
#endif

/*转化前的原始数据*/
extern int16_t imu963ra_gyro_x, imu963ra_gyro_y, imu963ra_gyro_z ;       // 三轴陀螺仪数据      GYRO (陀螺仪)
extern int16_t imu963ra_acc_x,  imu963ra_acc_y,  imu963ra_acc_z;        // 三轴加速度计数据     ACC  (accelerometer 加速度计)
extern int16_t imu963ra_mag_x,  imu963ra_mag_y,  imu963ra_mag_z;        // 三轴磁力计数据      MAG  (magnetometer 磁力计)

/*滤波后的的原始数据*/
float imu963ra_gyro_x_out, imu963ra_gyro_y_out, imu963ra_gyro_z_out ;       // 三轴陀螺仪数据      GYRO (陀螺仪)
float imu963ra_acc_x_out,  imu963ra_acc_y_out,  imu963ra_acc_z_out;        // 三轴加速度计数据     ACC  (accelerometer 加速度计)
float imu963ra_mag_x_out,  imu963ra_mag_y_out,  imu963ra_mag_z_out;        // 三轴磁力计数据      MAG  (magnetometer 磁力计)
uint8_t flag_filter_run=0;//滤波器首次启动，用于去除缓拟合的
float alpha_for_acc=0.45,alpha_for_gyro=0.4,alpha_for_mag=1;
/*转化后的数据*/
float imu963ra_gyro_x_transition, imu963ra_gyro_y_transition, imu963ra_gyro_z_transition;
float imu963ra_acc_x_transition,  imu963ra_acc_y_transition,  imu963ra_acc_z_transition;
float imu963ra_mag_x_transition,  imu963ra_mag_y_transition,  imu963ra_mag_z_transition;

extern volatile uint8_t if_We_Should_Infrom_Main_Function_to_PID;/*定时器触发发送消息到驱动后，驱动立刻回传轮子转速数值，之后进入主控进行PID得到对应的目标Pitch，再把目标角度回传回去，给驱动做PID*/
extern volatile uint32_t CAN_Time_Out_Counter;/*CAN超时计数器*/

#define Formal 4
#define Central_Driver 1


#if Central_Driver
float angle[3];                      /* Pitch、Yaw、Roll，度；仅主循环写 */
volatile float Speed[2]={0};//双轮转速,单位是：rpm
/* TIM2累计毫秒，可自然回绕；跳跃按无符号差值计时，不清零这个公共时钟。 */
static volatile uint32_t control_time_ms;/*一个全局时钟，允许回绕。。*/
volatile uint8_t flag_to_update_PID=0, flag_to_update_Attitude=0;/* 普通控制和姿态的独立通知 */
/* 初始目标采用合法工作区内的宏；首次下发成功后表示最近一次指令位置。 */
 float current_leg_height[2]={FOOT_INITIAL_Y_MM, FOOT_INITIAL_Y_MM};/*足端Y位置初始化*/
 float current_leg_x[2]={FOOT_INITIAL_X_MM, FOOT_INITIAL_X_MM};/*足端X位置初始化*/
 float current_target_angle_pitch_yaw[2]={0};/*当前目标角度，第一个是pitch 第二个是yaw*/
extern LegIK_Geometry My_LegIK_Geometry;
extern LegIK_Angles Left_LegIK_Angles ;
extern LegIK_Angles Right_LegIK_Angles;
PID Speed_PID;/*给电机驱动板的PID，根据目标速度和当前速度求出需要的倾角pitch*/
FootPID Foot_PID;/*足端位置的PID*/

/*-----------------------------------------遥控接口----------------------------------------*/
/*这个目标速度和current_target_angle_pitch_yaw[1]还有Jump_Request 就是Lora模块应该接受的数据了*/
volatile float target_Speed=0.0f;/*目标速度，单位是：rpm*/
/*----------------------------------------------------------------------------------------*/

#else
volatile float the_angles[2]={0};//应当依次为Pitch、Yaw角,接收主控传来的角度信息
volatile  float leg_height[2]={0};//标记腿高也就是y坐标的，由上位机发送而来
volatile float target_angle[2]={0};
#endif



static void IMU_TimerInit(void)
{
    RCC_ClocksTypeDef clocks;
    TIM_TimeBaseInitTypeDef timer;
    NVIC_InitTypeDef nvic;
    uint32_t tim_hz;
    RCC_GetClocksFreq(&clocks);
    tim_hz = clocks.PCLK1_Frequency;
    if (clocks.PCLK1_Frequency != clocks.HCLK_Frequency) tim_hz *= 2u;
    RCC_APB1PeriphClockCmd(RCC_APB1Periph_TIM2, ENABLE);
    TIM_DeInit(TIM2);
    TIM_TimeBaseStructInit(&timer);
    timer.TIM_Prescaler = (uint16_t)(tim_hz/1000000u-1u); /* 1us/计数 */
    timer.TIM_Period = IMU_PERIOD_MS*1000u-1u;
    TIM_TimeBaseInit(TIM2, &timer);
    TIM_ClearITPendingBit(TIM2, TIM_IT_Update); /* 清除初始化UG产生的UIF */
    flag_to_update_PID = 0;
    flag_to_update_Attitude = 0;
    /* Serial_Init已设置分组2，TIM2优先于USART1接收中断。 */
    nvic.NVIC_IRQChannel = TIM2_IRQn;
    nvic.NVIC_IRQChannelPreemptionPriority = 0;
    nvic.NVIC_IRQChannelSubPriority = 0;
    nvic.NVIC_IRQChannelCmd = ENABLE;
    NVIC_Init(&nvic);
    TIM_ITConfig(TIM2, TIM_IT_Update, ENABLE);
    TIM_Cmd(TIM2, DISABLE);
}
uint32_t inner_counter_PID=0, inner_counter_Attitude=0;/* 各自累计毫秒 */
void TIM2_IRQHandler(void)
{
    if (TIM_GetITStatus(TIM2, TIM_IT_Update) == SET) {
        TIM_ClearITPendingBit(TIM2, TIM_IT_Update);
        control_time_ms += IMU_PERIOD_MS;
        inner_counter_PID += IMU_PERIOD_MS;
        inner_counter_Attitude += IMU_PERIOD_MS;
        if(inner_counter_Attitude>=IMU_ATTITUDE_PERIOD_MS)
        {
            inner_counter_Attitude=0;
            flag_to_update_Attitude = 1;
        }
        if(inner_counter_PID>=FOOT_PID_PERIOD_MS)
        {
            inner_counter_PID=0;
            flag_to_update_PID = 1;
		    CAN_Time_Out_Counter++;//计数自增
        }
    }
}

static void Control_Fault(const char *message)
{
    Robot_State = ROBOT_FAULT;
    /* 停止发送控制数据；驱动板由自己的CAN超时路径停止PWM。 */
    while (1) {
        printf("%s\n", message);
        Delay_ms(500);
    }
}

/* 只在进入/退出跳跃时握手；收到确认才改变另一块板的控制职责。 */
static void Drive_SetMode(uint8_t mode)
{
    uint32_t started = control_time_ms;
    CAN_DriveModeAck = CAN_DRIVE_NONE;
    while (!CAN_SendDriveMode(mode))
        if ((uint32_t)(control_time_ms - started) >= 100u) Control_Fault("Drive mode send timeout");
    while (CAN_DriveModeAck != mode)/*这是在等待驱动板回应*/
        if ((uint32_t)(control_time_ms - started) >= 100u) Control_Fault("Drive mode ACK timeout");
    if_We_Should_Infrom_Main_Function_to_PID = 0;
    CAN_Time_Out_Counter = 0;
}
/*读取加速度*/
static float Read_Acceleration(void)
{
    imu963ra_get_acc();
    if (imu963ra_spi_error) Control_Fault("IMU SPI error");
    imu963ra_acc_x_transition = imu963ra_acc_transition(imu963ra_acc_x);
    imu963ra_acc_y_transition = imu963ra_acc_transition(imu963ra_acc_y);
    imu963ra_acc_z_transition = imu963ra_acc_transition(imu963ra_acc_z);
    return sqrtf(imu963ra_acc_x_transition*imu963ra_acc_x_transition +
                 imu963ra_acc_y_transition*imu963ra_acc_y_transition +
                 imu963ra_acc_z_transition*imu963ra_acc_z_transition);
}

uint32_t last_sampled_cycles = 0; /* 单位CPU周期；必须与DWT快照相减 */
static void Read_Attitude(void)
{
    uint32_t sampled_cycles, elapsed_cycles;
    uint8_t use_acc = Robot_State == ROBOT_NORMAL; /* 跳跃冲击/失重时不用加速度修正倾角。 */
    if (use_acc) (void)Read_Acceleration(); /* 跳跃加速度由Jump_Update独立采集 */
    imu963ra_get_gyro();
    imu963ra_get_mag();
    if (imu963ra_spi_error) Control_Fault("IMU SPI error");
    imu963ra_gyro_x_transition = imu963ra_gyro_transition(imu963ra_gyro_x);
    imu963ra_gyro_y_transition = imu963ra_gyro_transition(imu963ra_gyro_y);
    imu963ra_gyro_z_transition = imu963ra_gyro_transition(imu963ra_gyro_z);
    imu963ra_mag_x_transition = imu963ra_mag_transition(imu963ra_mag_x);
    imu963ra_mag_y_transition = imu963ra_mag_transition(imu963ra_mag_y);
    imu963ra_mag_z_transition = imu963ra_mag_transition(imu963ra_mag_z);

    sampled_cycles = IMU_CYCLE_NOW;
    elapsed_cycles = (uint32_t)(sampled_cycles - last_sampled_cycles);
    last_sampled_cycles = sampled_cycles; /* 同一次快照作下次基准，计入本轮解算耗时 */
    if (!IMU_9Axis_Gyro_Acc_Mag(
            use_acc ? imu963ra_acc_x_transition : 0.0f,
            use_acc ? imu963ra_acc_y_transition : 0.0f,
            use_acc ? imu963ra_acc_z_transition : 0.0f,
            imu963ra_gyro_x_transition, imu963ra_gyro_y_transition, imu963ra_gyro_z_transition,
            imu963ra_mag_x_transition, imu963ra_mag_y_transition, imu963ra_mag_z_transition,
            &angle[0], &angle[2], &angle[1], (float)elapsed_cycles / (float)SystemCoreClock))
        Control_Fault("IMU attitude invalid");

}

static void Resume_Control(void)
{
    /* 姿态始终连续更新；恢复时只清PID历史，沿用当前姿态。 */
    PID_Reset(&Speed_PID);
    PID_Reset(&Foot_PID.roll);
    PID_Reset(&Foot_PID.x[0]);
    PID_Reset(&Foot_PID.x[1]);
    target_Speed = 0;
    current_target_angle_pitch_yaw[0] = 0;
    current_target_angle_pitch_yaw[1] = angle[1];
    Drive_SetMode(CAN_DRIVE_RESUME);
    Jump_Request = 0; /* 丢弃跳跃/恢复期间残留的请求，避免落地后立即再次起跳。 */
}

#if (Formal==1)
int main(void)
{
    NVIC_PriorityGroupConfig(NVIC_PriorityGroup_2);/*上位机一定要设置为优先级4，FreeRTOS的普通要求*/
    Servo_Init(SERVO_PERIOD_US);
    Leg_ResetFootPositionHistory();
    Serial_Init();
    if (!CAN_Init_Together()) Control_Fault("CAN init failed");
    while (imu963ra_init()) {}
    Delay_s(5);/*先等待一下,等待IMU完全稳定，经过测试，不等待稳定会出现BUG*/
    IMU_TimerInit(); /* 仍由调试启动处开启TIM2 */
    SpeedPID_Init(&Speed_PID);
    FootPID_Init(&Foot_PID);
    if (Leg_SetFootPositions(current_leg_x, current_leg_height) != LEG_IK_OK)
        Control_Fault("Initial foot position rejected");
    last_sampled_cycles = IMU_CYCLE_NOW; /* 预热结束后建立DWT基准，不能使用毫秒时钟 */
    flag_to_update_Attitude = 1; /* 第一次普通控制前先取得姿态 */
    TIM_Cmd(TIM2,ENABLE);
    while (1) {
        float wheels[2], next_x[2], next_y[2];
        uint8_t pid_due, attitude_due;

        if(Serial_ProcessControl()) /* 接收遥控目标，保持PID和跳跃在主循环执行 */
            Serial_SendFeedback((Speed[0]+Speed[1])/2,angle[1]);
        if (Robot_State == ROBOT_FAULT) Control_Fault("Jump failed");
        if (Robot_State == ROBOT_NORMAL && CAN_Time_Out_Counter > 3)
            Control_Fault("CAN Time Out");

        
        /* 读取通知和清零一起保护；跳跃不受这两个通知限制。 */
        NVIC_DisableIRQ(TIM2_IRQn);
        pid_due = flag_to_update_PID;
        attitude_due = flag_to_update_Attitude;
        flag_to_update_PID = 0;
        flag_to_update_Attitude = 0;
        NVIC_EnableIRQ(TIM2_IRQn);

        if (attitude_due) Read_Attitude(); /* 普通运行/跳跃都独立按宏所定义时间解算，这里读取更新时间到了，更新角度！ */
        if (Jump_Request) {
            Jump_Request = 0; /* 跳跃中再次请求直接消费，不重新启动 */
            if (Robot_State == ROBOT_NORMAL) {
                Drive_SetMode(CAN_DRIVE_PAUSE); /* 确认两路PWM已停，才允许移动腿 */
                target_Speed = 0;
                if (Jump_Start(control_time_ms) == JUMP_ERROR) {
                    if (Robot_State == ROBOT_FAULT) Control_Fault("Jump command failed");
                    printf("Jump target rejected\n");
                    Resume_Control();
                }
                continue;
            }
        }
        if (Robot_State != ROBOT_NORMAL) {
            int8_t result = Jump_Update(control_time_ms); /* 每轮检查1ms时钟，内部按需采集加速度 */
            if (result == JUMP_ERROR) Control_Fault("Jump failed");/*跳跃错误后，此处卡死*/
            if (result == JUMP_LANDED) Resume_Control();/*成功落地，通知恢复控制*/ */
            continue; /* 必须位于普通CAN/PID之前：跳跃期间屏蔽下面的控制帧和PID。 */
        }
        if(pid_due) { /* 跳跃期间的PID通知已消费，不积压到恢复后 */
            while (!CAN_Angle_and_LegHeight_Send_First_Package(
                    angle[0], angle[1], current_leg_height[0], current_leg_height[1]))
                if (CAN_Time_Out_Counter > 3) Control_Fault("CAN Time Out");
            while (!CAN_TakeWheelSpeed(wheels))
                if (CAN_Time_Out_Counter > 3) Control_Fault("CAN Time Out");
            if (!SpeedPID_Update(&Speed_PID, target_Speed, wheels, &current_target_angle_pitch_yaw[0]))
                Control_Fault("Speed PID invalid");
            while (!CAN_Angle_and_LegHeight_Send_Second_Package(
                    current_target_angle_pitch_yaw[0], current_target_angle_pitch_yaw[1]))
                if (CAN_Time_Out_Counter > 3) Control_Fault("CAN Time Out");
            if (FootPID_Update(&Foot_PID, angle[2], wheels,
                    current_leg_x, current_leg_height, next_x, next_y)) {
                LegIK_Result status = Leg_SetFootPositions(next_x, next_y);
                if (status == LEG_IK_OK) {
                    for (unsigned i = 0; i < 2; ++i) {
                        current_leg_x[i] = next_x[i];
                        current_leg_height[i] = next_y[i];
                    }
                } else printf("Foot position rejected: %d\n", (int)status);
            }
        }
    }
}
#elif (Formal==2) /*调试用，带磁力计*/
/* 仅调试模式上电采集。正式模式使用IMU.h中已经填写的校准参数。 */
static void Calibrate_Magnetometer(void)
{
#if !MAG_USE_PRESET_CALIBRATION
    uint32_t i;
    for (;;) {
        Mag_Calibrate_Begin();
        printf("MAG CAL: slowly rotate/flip through all X/Y/Z directions.\n");
        printf("Keep away from magnets/steel. Do not only turn flat.\n");
        for (i = 0; i < MAG_CAL_SAMPLES; ++i) {
            imu963ra_get_mag();
            if (imu963ra_spi_error) Control_Fault("IMU SPI error");
            Mag_Calibrate_Collect(imu963ra_mag_transition(imu963ra_mag_x),
                                  imu963ra_mag_transition(imu963ra_mag_y),
                                  imu963ra_mag_transition(imu963ra_mag_z));
            if (i % 250u == 0u)
                printf("MAG CAL %lu/%lu\n", (unsigned long)i, (unsigned long)MAG_CAL_SAMPLES);
            Delay_ms(MAG_CAL_SAMPLE_MS);
        }
        if (Mag_Calibrate_Finish()) break;
        printf("MAG CAL retry: insufficient XYZ span or severe distortion.\n");
    }
#endif
    printf("MAG CAL OK. Copy these measured values into IMU.h to reuse:\n");
    printf("#define MAG_USE_PRESET_CALIBRATION 1\n");
    printf("#define MAG_BIAS_X_G %.6ff\n", mag_calib.bias[0]);
    printf("#define MAG_BIAS_Y_G %.6ff\n", mag_calib.bias[1]);
    printf("#define MAG_BIAS_Z_G %.6ff\n", mag_calib.bias[2]);
    printf("#define MAG_SCALE_X %.6ff\n", mag_calib.scale[0]);
    printf("#define MAG_SCALE_Y %.6ff\n", mag_calib.scale[1]);
    printf("#define MAG_SCALE_Z %.6ff\n", mag_calib.scale[2]);
    printf("Place IMU level and still; starting in 2 seconds.\n");
    Delay_ms(2000u);
    printf("Pitch,Yaw,Roll,MagHeading,mx_raw,my_raw,mz_raw\n");
}

int main(void)
{
    
    /* 姿态积分统一使用DWT周期差。 */

//	Servo_Init(SERVO_PERIOD_US); /* TIM3: no pulses until Servo_SetPulse/Servo_SetAngle. */
	Serial_Init();/*来个串口，我板子上应该花了接口，先打开*/
	IMU_TimerInit();/*来个定时老弟*/
//	Servo_Init(SERVO_PERIOD_US);/*20000us也就是20ms*/
//	CAN_Init_Together();/*CAN初始化*/
	printf("Start\n");
	while(imu963ra_init()){};/*陀螺仪初始化*/
	printf("OK\n");
    Delay_s(5);/*先等待一下*/
    Calibrate_Magnetometer();

    last_sampled_cycles = IMU_CYCLE_NOW;
		TIM_Cmd(TIM2, ENABLE);
    while (1) {
        //Serial_ProcessControl(); /* 调试模式也可接收，printf照常使用 */
				if(flag_to_update_Attitude==1)
				{
					flag_to_update_Attitude=0;
					
					imu963ra_get_acc();
					imu963ra_get_gyro();
					imu963ra_get_mag();
                    if (imu963ra_spi_error) Control_Fault("IMU SPI error");
                    uint32_t sampled_cycles = IMU_CYCLE_NOW; /* 同一次DWT快照用于差值和下次基准 */
					if(!flag_filter_run)
					{
						imu963ra_acc_x_out=imu963ra_acc_x;
						imu963ra_acc_y_out=imu963ra_acc_y;
						imu963ra_acc_z_out=imu963ra_acc_z;
						imu963ra_gyro_x_out=imu963ra_gyro_x;
						imu963ra_gyro_y_out=imu963ra_gyro_y;
						imu963ra_gyro_z_out=imu963ra_gyro_z;
						imu963ra_mag_x_out=imu963ra_mag_x;
						imu963ra_mag_y_out=imu963ra_mag_y;
						imu963ra_mag_z_out=imu963ra_mag_z;
                        /* 校准结束后的第一帧直接建立初始姿态，避免从Yaw=0慢慢追赶。 */
                        if (!IMU_ResetAttitude(
                                imu963ra_acc_transition(imu963ra_acc_x_out),
                                imu963ra_acc_transition(imu963ra_acc_y_out),
                                imu963ra_acc_transition(imu963ra_acc_z_out),
                                imu963ra_mag_transition(imu963ra_mag_x_out),
                                imu963ra_mag_transition(imu963ra_mag_y_out),
                                imu963ra_mag_transition(imu963ra_mag_z_out),
                                &angle[2], &angle[0], &angle[1])) continue;
						flag_filter_run=1;
                        last_sampled_cycles = sampled_cycles;
                        continue;
					}
					imu963ra_acc_x_out+=alpha_for_acc*(imu963ra_acc_x-imu963ra_acc_x_out);
					imu963ra_acc_y_out+=alpha_for_acc*(imu963ra_acc_y-imu963ra_acc_y_out);
					imu963ra_acc_z_out+=alpha_for_acc*(imu963ra_acc_z-imu963ra_acc_z_out);
					imu963ra_gyro_x_out+=alpha_for_gyro*(imu963ra_gyro_x-imu963ra_gyro_x_out);
					imu963ra_gyro_y_out+=alpha_for_gyro*(imu963ra_gyro_y-imu963ra_gyro_y_out);
					imu963ra_gyro_z_out+=alpha_for_gyro*(imu963ra_gyro_z-imu963ra_gyro_z_out);
					imu963ra_mag_x_out+=alpha_for_mag*(imu963ra_mag_x-imu963ra_mag_x_out);
					imu963ra_mag_y_out+=alpha_for_mag*(imu963ra_mag_y-imu963ra_mag_y_out);
					imu963ra_mag_z_out+=alpha_for_mag*(imu963ra_mag_z-imu963ra_mag_z_out);
				
					
					
					imu963ra_acc_x_transition=imu963ra_acc_transition(imu963ra_acc_x_out);
					imu963ra_acc_y_transition=imu963ra_acc_transition(imu963ra_acc_y_out);
					imu963ra_acc_z_transition=imu963ra_acc_transition(imu963ra_acc_z_out);
					imu963ra_gyro_x_transition=imu963ra_gyro_transition(imu963ra_gyro_x_out);
					imu963ra_gyro_y_transition=imu963ra_gyro_transition(imu963ra_gyro_y_out);
					imu963ra_gyro_z_transition=imu963ra_gyro_transition(imu963ra_gyro_z_out);
					imu963ra_mag_x_transition=imu963ra_mag_transition(imu963ra_mag_x_out);
					imu963ra_mag_y_transition=imu963ra_mag_transition(imu963ra_mag_y_out);
					imu963ra_mag_z_transition=imu963ra_mag_transition(imu963ra_mag_z_out);

                    						
                    uint32_t record_time = (uint32_t)(sampled_cycles - last_sampled_cycles);
                    last_sampled_cycles = sampled_cycles;
					if (!IMU_9Axis_Gyro_Acc_Mag(imu963ra_acc_x_transition, imu963ra_acc_y_transition, imu963ra_acc_z_transition, 
					imu963ra_gyro_x_transition, imu963ra_gyro_y_transition, imu963ra_gyro_z_transition, 
					imu963ra_mag_x_transition, imu963ra_mag_y_transition, imu963ra_mag_z_transition, 
					&angle[0], &angle[2], &angle[1], (float)record_time / (float)SystemCoreClock))
                        Control_Fault("IMU attitude invalid");
                 //   printf("%ld,%f,%f,%f\n",record_time,angle[0],angle[1],angle[2]);
				 //	printf("%d,%d,%d,%d,%d,%d\n",imu963ra_gyro_x_out,imu963ra_gyro_y_out,imu963ra_gyro_z_out,imu963ra_gyro_x,imu963ra_gyro_y,imu963ra_gyro_z);				
                //  printf("%d,%d,%d,%d,%d,%d\n",imu963ra_mag_x_out,imu963ra_mag_y_out,imu963ra_mag_z_out,imu963ra_mag_x,imu963ra_mag_y,imu963ra_mag_z);				
                    float mag_heading;
                    /* 两个解算函数各自校准局部副本一次，不能先校准transition再传入。 */
                    if (!Mag_GetHeading(imu963ra_mag_x_transition, imu963ra_mag_y_transition,
                                        imu963ra_mag_z_transition, angle[2], angle[0], &mag_heading))
                        mag_heading = NAN;
                    /* 最后三列仍是滤波后的原始计数；第4列为校准+倾斜补偿后的磁航向。 */
                    printf("%.2f,%.2f,%.2f,%.2f,%d,%d,%d\n",
                        angle[0],angle[2],angle[1], mag_heading,
                        (int)imu963ra_mag_x_out,
                        (int)imu963ra_mag_y_out,
                        (int)imu963ra_mag_z_out);
                        
				}
//					Delay_ms(IMU_PERIOD_MS);
//					data=spi_read_write_byte(SPI2,0XA5);
//					printf("%c\n",data);

    }
}
#elif (Formal==3) /*调试用，不带磁力计*/

int main(void)
{

//	Servo_Init(SERVO_PERIOD_US); /* TIM3: no pulses until Servo_SetPulse/Servo_SetAngle. */
	Serial_Init();/*来个串口，我板子上应该花了接口，先打开*/
	IMU_TimerInit();/*来个定时老弟*/
//	Servo_Init(SERVO_PERIOD_US);/*20000us也就是20ms*/
//	CAN_Init_Together();/*CAN初始化*/
	printf("Start\n");
	while(imu963ra_init()){};/*陀螺仪初始化*/
	printf("OK\n");
    Delay_s(5);/*先等待一下,等待IMU完全稳定*/
   // Calibrate_Magnetometer();

	TIM_Cmd(TIM2, ENABLE);
    last_sampled_cycles = IMU_CYCLE_NOW;
    while (1) {
        //Serial_ProcessControl(); /* 调试模式也可接收，printf照常使用 */
				if(flag_to_update_Attitude==1)
				{
					flag_to_update_Attitude=0;
					
					imu963ra_get_acc();
					imu963ra_get_gyro();
					imu963ra_get_mag();
                    if (imu963ra_spi_error) Control_Fault("IMU SPI error");
					if(!flag_filter_run)
					{
                        flag_filter_run=1;
						imu963ra_acc_x_out=imu963ra_acc_x;
						imu963ra_acc_y_out=imu963ra_acc_y;
						imu963ra_acc_z_out=imu963ra_acc_z;
						imu963ra_gyro_x_out=imu963ra_gyro_x;
						imu963ra_gyro_y_out=imu963ra_gyro_y;
						imu963ra_gyro_z_out=imu963ra_gyro_z;
						imu963ra_mag_x_out=imu963ra_mag_x;
						imu963ra_mag_y_out=imu963ra_mag_y;
						imu963ra_mag_z_out=imu963ra_mag_z;
                        /* 校准结束后的第一帧直接建立初始姿态，避免从Yaw=0慢慢追赶。 */
					}
					imu963ra_acc_x_out+=alpha_for_acc*(imu963ra_acc_x-imu963ra_acc_x_out);
					imu963ra_acc_y_out+=alpha_for_acc*(imu963ra_acc_y-imu963ra_acc_y_out);
					imu963ra_acc_z_out+=alpha_for_acc*(imu963ra_acc_z-imu963ra_acc_z_out);
					imu963ra_gyro_x_out+=alpha_for_gyro*(imu963ra_gyro_x-imu963ra_gyro_x_out);
					imu963ra_gyro_y_out+=alpha_for_gyro*(imu963ra_gyro_y-imu963ra_gyro_y_out);
					imu963ra_gyro_z_out+=alpha_for_gyro*(imu963ra_gyro_z-imu963ra_gyro_z_out);
					imu963ra_mag_x_out+=alpha_for_mag*(imu963ra_mag_x-imu963ra_mag_x_out);
					imu963ra_mag_y_out+=alpha_for_mag*(imu963ra_mag_y-imu963ra_mag_y_out);
					imu963ra_mag_z_out+=alpha_for_mag*(imu963ra_mag_z-imu963ra_mag_z_out);

                    						
					imu963ra_acc_x_transition=imu963ra_acc_transition(imu963ra_acc_x_out);
					imu963ra_acc_y_transition=imu963ra_acc_transition(imu963ra_acc_y_out);
					imu963ra_acc_z_transition=imu963ra_acc_transition(imu963ra_acc_z_out);
					imu963ra_gyro_x_transition=imu963ra_gyro_transition(imu963ra_gyro_x_out);
					imu963ra_gyro_y_transition=imu963ra_gyro_transition(imu963ra_gyro_y_out);
					imu963ra_gyro_z_transition=imu963ra_gyro_transition(imu963ra_gyro_z_out);

                    uint32_t sampled_cycles = IMU_CYCLE_NOW;
                    uint32_t record_time = (uint32_t)(sampled_cycles - last_sampled_cycles);
                    last_sampled_cycles = sampled_cycles;

					IMU_6Axis_Gyro_Acc(imu963ra_acc_x_transition, imu963ra_acc_y_transition, imu963ra_acc_z_transition, 
					imu963ra_gyro_x_transition, imu963ra_gyro_y_transition, imu963ra_gyro_z_transition,  
					&angle[0], &angle[2], &angle[1], (float)record_time / (float)SystemCoreClock);
                    

                 //   printf("%ld,%f,%f,%f\n",record_time,angle[0],angle[1],angle[2]);
				 //	printf("%d,%d,%d,%d,%d,%d\n",imu963ra_gyro_x_out,imu963ra_gyro_y_out,imu963ra_gyro_z_out,imu963ra_gyro_x,imu963ra_gyro_y,imu963ra_gyro_z);				
                //  printf("%d,%d,%d,%d,%d,%d\n",imu963ra_mag_x_out,imu963ra_mag_y_out,imu963ra_mag_z_out,imu963ra_mag_x,imu963ra_mag_y,imu963ra_mag_z);				
                    /* 最后三列仍是滤波后的原始计数；第4列为校准+倾斜补偿后的磁航向。 */
					static float sum=0;
					sum += (float)record_time * 1000.0f / (float)SystemCoreClock;
                    printf("%f,%.2f\n",sum/1000,angle[1]-(-4E-07 *(sum/1000)*(sum/1000)*(sum/1000) + 0.0002*(sum/1000)*(sum/1000) - 0.0437*(sum/1000) + 0.3289));                     
				}
//					Delay_ms(IMU_PERIOD_MS);
//					data=spi_read_write_byte(SPI2,0XA5);
//					printf("%c\n",data);

    }
}
#elif (Formal==4) /*调试用，Lora模块传输测试*/
extern volatile uint8_t Serial_RxData;
extern volatile uint8_t Serial_RxFlag;
int main(void)
{
    NVIC_PriorityGroupConfig(NVIC_PriorityGroup_2);
		Serial_Init_For_DeBug();/*来个串口，我板子上应该花了接口，先打开*/
		Serial_Init();
    last_sampled_cycles=*(volatile uint32_t *)0xE0001004u;
    while (1) {
        //Serial_ProcessControl(); /* 调试模式也可接收，printf照常使用 */
        if(Serial_RxFlag)
        {
            Serial_RxFlag=0;/*清空标志位*/
            printf("time(us):%.2f,data:0x%02X\n",(*(volatile uint32_t *)0xE0001004u- last_sampled_cycles)/72.0f,Serial_RxData);
            last_sampled_cycles=*(volatile uint32_t *)0xE0001004u;
        }
    }
}

#endif 
