xiaotianandbaihui-svg/Graduation_Design/Motor_Driver_KEIL/SVPWM/Hardware/svpwm.c

#include "svpwm.h"
#include "stm32f10x.h"
#include "stm32f10x_rcc.h"
#include "stm32f10x_tim.h"
#include "tle5012b.h"
#include <math.h>
#include "Delay.h"
#include "current_sense.h"
#include <stdio.h>

float zero_point_1=0,zero_point_2=0;//记录两个电机在磁编码器特定安装下的A相角度
float first_mechanical_angle=0,second_mechanical_angle=0;//记录电机当前机械角度
float electrical1=0,electrical2=0;//记录当前电机的电角度 [0°,360°)
static TIM_TypeDef * const timer[2] = {TIM2, TIM4};
static uint16_t period, current_compare_limit;
static uint8_t ready, running[2], calibrated;
static int8_t encoder_sign[2];

/* NULL时正常运行；只有Motor_InitTest期间记录并打印当前初始化步骤。 */
static const char *init_test_step;

static void InitTestStep(const char *step)
{
    if (init_test_step) init_test_step = step;
}

/* out为ODR命令，in为IDR实际引脚读回；参数必须先采集，再停机/打印。 */
static void PrintInitPins(const char *label, uint16_t ia, uint16_t ib,
                          uint16_t oa, uint16_t ob)
{
    printf("[%s] EN(out/in)=%u/%u CAL(out/in)=%u/%u nFAULT1/2=%u/%u\r\n",
           label, !!(oa & GPIO_Pin_0), !!(ia & GPIO_Pin_0),
           !!(ob & GPIO_Pin_4), !!(ib & GPIO_Pin_4),
           !!(ia & GPIO_Pin_8), !!(ib & GPIO_Pin_5));
    printf(" INL1 ABC(out/in)=%u%u%u/%u%u%u INL2 ABC(out/in)=%u%u%u/%u%u%u\r\n",
           !!(ob & GPIO_Pin_12), !!(ob & GPIO_Pin_11), !!(ob & GPIO_Pin_10),
           !!(ib & GPIO_Pin_12), !!(ib & GPIO_Pin_11), !!(ib & GPIO_Pin_10),
           !!(ob & GPIO_Pin_6), !!(ob & GPIO_Pin_3), !!(oa & GPIO_Pin_15),
           !!(ib & GPIO_Pin_6), !!(ib & GPIO_Pin_3), !!(ia & GPIO_Pin_15));
}

static void ClearCalibration(void)
{
    calibrated = 0u;
    encoder_sign[0] = encoder_sign[1] = 0;
    zero_point_1 = zero_point_2 = electrical1 = electrical2 = 0.0f;
}

int8_t SVPWM_GetEncoderSign(uint8_t id)
{
    return calibrated && id < 2u ? encoder_sign[id] : 0;
}


static float Wrap360(float angle)
{
    angle = fmodf(angle, 360.0f);
    if (angle < 0.0f) angle += 360.0f;
    return angle >= 360.0f ? 0.0f : angle;
}

/* 3PWM模式：INL=1时响应INH的PWM；INL=0时该相上下管均关闭。 */
void PhaseEnable(uint8_t id, BitAction state)
{
    if (id == 0u) {
        GPIO_WriteBit(GPIOB, GPIO_Pin_12 | GPIO_Pin_11 | GPIO_Pin_10, state);
    } else {
        GPIO_WriteBit(GPIOB, GPIO_Pin_6 | GPIO_Pin_3, state);
        GPIO_WriteBit(GPIOA, GPIO_Pin_15, state);
    }
}

void SVPWM_Stop(uint8_t id)
{
    if (ready && id < 2u) {
        PhaseEnable(id, Bit_RESET);
        running[id] = 0u;
    }
}

static int Fail(void)
{
    uint16_t ia = 0u, ib = 0u, oa = 0u, ob = 0u;
    if (init_test_step) {
        ia = GPIO_ReadInputData(GPIOA); ib = GPIO_ReadInputData(GPIOB);
        oa = GPIO_ReadOutputData(GPIOA); ob = GPIO_ReadOutputData(GPIOB);
    }
    SVPWM_Stop(0u);
    SVPWM_Stop(1u);
    GPIO_ResetBits(GPIOA, GPIO_Pin_0);
    ready = 0u;
    ClearCalibration();
    if (init_test_step) {
        printf("[FAIL] step=%s; both motors disabled\r\n", init_test_step);
        PrintInitPins("BEFORE_FAIL", ia, ib, oa, ob);
    }
    return 0;
}

volatile uint8_t fault1_level = 0;
volatile uint8_t fault2_level = 0;

static int DriverOK(void)
{
    fault1_level = GPIO_ReadInputDataBit(GPIOA, GPIO_Pin_8);
    fault2_level = GPIO_ReadInputDataBit(GPIOB, GPIO_Pin_5);

    return fault1_level == Bit_SET &&
           fault2_level == Bit_SET;
}

static void PinMode(GPIO_TypeDef *port, uint16_t pins, GPIOMode_TypeDef mode)
{
    GPIO_InitTypeDef gpio;
    gpio.GPIO_Pin = pins;
    gpio.GPIO_Mode = mode;
    gpio.GPIO_Speed = GPIO_Speed_50MHz;
    GPIO_Init(port, &gpio);
}

static void InitPWM(TIM_TypeDef *tim)
{
    TIM_TimeBaseInitTypeDef base;
    TIM_OCInitTypeDef oc;

    TIM_DeInit(tim);
    TIM_TimeBaseStructInit(&base);
    base.TIM_Prescaler = 0u;
    base.TIM_CounterMode = TIM_CounterMode_CenterAligned1;
    base.TIM_Period = period; /* 中心对齐：fPWM=fTIM/(2*ARR)，这里不减1。 */
    TIM_TimeBaseInit(tim, &base);

    TIM_OCStructInit(&oc);
    oc.TIM_OCMode = TIM_OCMode_PWM1;
    oc.TIM_OutputState = TIM_OutputState_Enable;
    oc.TIM_OCPolarity = TIM_OCPolarity_High;
    oc.TIM_Pulse = period / 2u;
    TIM_OC2Init(tim, &oc);
    TIM_OC3Init(tim, &oc);
    TIM_OC4Init(tim, &oc);
    TIM_OC2PreloadConfig(tim, TIM_OCPreload_Enable);
    TIM_OC3PreloadConfig(tim, TIM_OCPreload_Enable);
    TIM_OC4PreloadConfig(tim, TIM_OCPreload_Enable);
    TIM_ARRPreloadConfig(tim, ENABLE);
    TIM_GenerateEvent(tim, TIM_EventSource_Update);
    TIM_ClearFlag(tim, TIM_FLAG_Update);
    TIM_Cmd(tim, ENABLE);
}

int SVPWM_Init(void)
{
    RCC_ClocksTypeDef clocks;
    uint32_t tim_hz, counts;

    RCC_APB2PeriphClockCmd(RCC_APB2Periph_GPIOA | RCC_APB2Periph_GPIOB |
                          RCC_APB2Periph_AFIO, ENABLE);
    /* 先预置ODR低，再切输出模式，避免切换时出现高电平。 */
    GPIO_ResetBits(GPIOA, GPIO_Pin_0);
    PinMode(GPIOA, GPIO_Pin_0, GPIO_Mode_Out_PP);
    ready = running[0] = running[1] = 0u;
    current_compare_limit = 0u;
    ClearCalibration();/*点进去看看就知道了*/
    GPIO_PinRemapConfig(GPIO_FullRemap_TIM2, DISABLE);
    GPIO_PinRemapConfig(GPIO_Remap_TIM4, DISABLE);
    GPIO_PinRemapConfig(GPIO_Remap_SWJ_JTAGDisable, ENABLE);

    GPIO_SetBits(GPIOB, GPIO_Pin_4); /* CAL：释放JTAG后拉低，先于EN使能。 */
    
    /*DRV芯片的校准信号引脚CAL*/
    PinMode(GPIOB, GPIO_Pin_4, GPIO_Mode_Out_PP);
    Delay_us(200u);
    GPIO_ResetBits(GPIOB,GPIO_Pin_4);/*我为了保险啊，还是保持校准200~300us，(因为stm32芯片复位后这个引脚本身也是弱上拉的)，DRV要求至少100us
    那我就给充足时间校准！*/

    /* 初始化时INLA/B/C拉低，保持高阻；首次SVPWM_Set装载PWM后才拉高。 */
    PhaseEnable(0u, Bit_RESET);
    PhaseEnable(1u, Bit_RESET);

    /*DRV8323的INLA/B/C引脚*/
    PinMode(GPIOB, GPIO_Pin_12 | GPIO_Pin_11 | GPIO_Pin_10 |
                   GPIO_Pin_6 | GPIO_Pin_3, GPIO_Mode_Out_PP);
    PinMode(GPIOA, GPIO_Pin_15, GPIO_Mode_Out_PP);

    /*两个DRV芯片的两个nFAULT引脚*/
    PinMode(GPIOA, GPIO_Pin_8, GPIO_Mode_IPU);
    PinMode(GPIOB, GPIO_Pin_5, GPIO_Mode_IPU);

    /* 只读取已配置的时钟；APB1有分频时，定时器时钟为PCLK1的两倍。 */
    RCC_GetClocksFreq(&clocks);
    tim_hz = clocks.PCLK1_Frequency;
    if (clocks.PCLK1_Frequency != clocks.HCLK_Frequency) tim_hz *= 2u;
    InitTestStep("PWM clock");
    counts = tim_hz / (2u * SVPWM_PWM_HZ);/*20khz对应的是1800*/
    if (init_test_step)
        printf("[CLOCK] HCLK=%lu TIM=%lu ADC=%luHz ARR=%lu\r\n",
               (unsigned long)clocks.HCLK_Frequency, (unsigned long)tim_hz,
               (unsigned long)(clocks.PCLK2_Frequency / 6u), (unsigned long)counts);
    if (counts < 2u || counts > 65535u) return Fail();
    period = (uint16_t)counts;/*这里特别说明，PWM1模式下，中心对齐(中心对齐有向上计数和向下计数两个阶段)，向上计数时候CNT<CCRx输出有效电平
    向下计数的时候CNT≤CCRx的时候输出有效电平*/

    RCC_APB1PeriphClockCmd(RCC_APB1Periph_TIM2 | RCC_APB1Periph_TIM4, ENABLE);

    InitPWM(TIM2);/*此处对两个定时器初始化，正式使用到前面配置的period*/
    InitPWM(TIM4);

    PinMode(GPIOA, GPIO_Pin_1 | GPIO_Pin_2 | GPIO_Pin_3, GPIO_Mode_AF_PP);
    PinMode(GPIOB, GPIO_Pin_7 | GPIO_Pin_8 | GPIO_Pin_9, GPIO_Mode_AF_PP);

    Delay_us(2000u);
    GPIO_SetBits(GPIOA, GPIO_Pin_0);/*就是给DRV8323的EN拉高了*/
    Delay_us(2000u); /* 等待DRV唤醒，INL仍全为低。 */
    ready = 1u;/*可见，这里的ready表示给DRV8323的相关引脚已经配置完成，DRV芯片的硬件校准步骤已经完成*/
    /* INL仍全低、MOS不切换时完成CSA校准及四路ADC零偏采集。 */
    InitTestStep("DRV wake / nFAULT");
    if (!DriverOK()) return Fail();
    InitTestStep("ADC / CSA zero calibration");
    if (!CurrentSense_Init()) return Fail();
    if (init_test_step) {
        uint8_t id;
        float a, b;
        PrintInitPins("DRV_READY", GPIO_ReadInputData(GPIOA), GPIO_ReadInputData(GPIOB),
                      GPIO_ReadOutputData(GPIOA), GPIO_ReadOutputData(GPIOB));
        for (id = 0u; id < 2u; ++id) {
            if (CurrentSense_GetZero(id, &a, &b))
                printf("[ADC M%u] zero_A=%.2f (%.3fV) zero_B=%.2f (%.3fV)\r\n",
                       (unsigned)(id + 1u), a, a * CURRENT_SENSE_VDDA_V / 4096.0f,
                       b, b * CURRENT_SENSE_VDDA_V / 4096.0f);
        }
    }
    return 1;
}

static uint16_t Compare(float duty)
{
    /* 吸收浮点舍入误差；CCR范围0~ARR。 */
    if (duty <= 0.0f) return 0u;
    if (duty >= 1.0f) return period;
    return (uint16_t)(duty * (float)period + 0.5f);/*加零点五四舍五入了*/
}

/*当前暂且使用纯粹的电压环*/
int SVPWM_Set(uint8_t id, float voltage_deg, uint16_t modulation)
{
    float angle, amplitude, alpha, beta, a, b, c, offset;
    uint16_t ca, cb, cc;
    TIM_TypeDef *tim;

    if (!ready) return 0;
    if (id > 1u || !isfinite(voltage_deg) || modulation > SVPWM_MAX_MOD ||
        !DriverOK()) return Fail();
    if (modulation == 0u) {
        SVPWM_Stop(id);
        return 1;
    }
    angle = Wrap360(voltage_deg);
    angle *= 0.01745329252f;
    amplitude = (float)modulation * (0.57735026919f / SVPWM_MAX_MOD);
    alpha = amplitude * cosf(angle);
    beta  = amplitude * sinf(angle);

    /* 逆Clarke：以母线电压归一化的三相电压。 */
    a = alpha;
    b = -0.5f * alpha + 0.86602540378f * beta;
    c = -0.5f * alpha - 0.86602540378f * beta;
    /* 注入公共偏移：与线性区对称SVPWM等价，不改变三相线电压。 */
    offset = 0.5f - 0.5f * (fmaxf(a, fmaxf(b, c)) + fminf(a, fminf(b, c)));
    ca = Compare(a + offset);
    cb = Compare(b + offset);
    cc = Compare(c + offset);

    tim = timer[id];
    /* 暂停更新事件，防止三个CCR写到一半就被装载；计数器照常运行。 */
    TIM_UpdateDisableConfig(tim, ENABLE);
    TIM_SetCompare2(tim, ca);
    TIM_SetCompare3(tim, cb);
    TIM_SetCompare4(tim, cc);
    TIM_UpdateDisableConfig(tim, DISABLE);
    if (!running[id]) {
        /* 仅从高阻启动时立即装载；正常运行不强制UG，避免重置PWM相位。 */
        TIM_GenerateEvent(tim, TIM_EventSource_Update);
        TIM_ClearFlag(tim, TIM_FLAG_Update);
        PhaseEnable(id, Bit_SET);
        running[id] = 1u;
    }
    return 1;
}

/* 保持给定矢量，先等待500ms，再要求100ms内角度变化不超过0.25度。
 * 最多等待1500ms；读取失败或nFAULT异常立即退出。 */
static int AlignAndRead(uint8_t id, float voltage_deg, float *mechanical)
{
    uint32_t elapsed, stable_ms = 0u;
    float current = 0.0f, reference = 0.0f;
    TLE_Result result;

    if (!SVPWM_Set(id, voltage_deg, SVPWM_ALIGN_MOD)) return 0;
    for (elapsed = 10u; elapsed <= 1500u; elapsed += 10u) {
        Delay_ms(10u);
        if (!DriverOK()) return Fail();
        result = TLE5012B_ReadAngle(id, &current); /* 机械角，单位度 */
        if (result != TLE_OK || !isfinite(current) || current < 0.0f || current >= 360.0f) {
            Fail(); /* 先停机，不能带着对齐电压等待串口打印。 */
            if (init_test_step)
                printf("[ENC M%u] read_result=%d angle=%.3fdeg (invalid)\r\n",
                       (unsigned)(id + 1u), (int)result, current);
            return 0;
        }
        if (elapsed <= 500u ||
            fabsf(Wrap360(current - reference + 180.0f) - 180.0f) > 0.25f) {/*把角度差值限制在[-180°,180°)范围内 */
            reference = current;
            stable_ms = 0u;
        } else {
            stable_ms += 10u;
        }
        if (stable_ms >= 500u) {
            *mechanical = current;
            return 1;
        }
    }
    Fail();
    if (init_test_step)
        printf("[ALIGN M%u] not stable within 1500ms; last=%.3fdeg\r\n",
               (unsigned)(id + 1u), current);
    return 0;
}
/*主函数对于电机部分的更新直接调用这个函数就好，这个函数会递归调用ADC初始化，DRV初始化的*/
int Motor_init(void)
{
    float zeros[2], angle180[2], delta, expected;
    int8_t signs[2];
    uint8_t id;
    TLE_Result result;
    uint16_t ia = 0u, ib = 0u, oa = 0u, ob = 0u;

    InitTestStep("PWM / GPIO init");
    if (!SVPWM_Init()) return 0;/*这里主要是对DRV8323芯片的初始化，对ADC初始化，得到DRV8323的基准电压*/
    InitTestStep("alignment parameters");
    if (SVPWM_POLE_PAIRS == 0u || SVPWM_ALIGN_MOD == 0u ||
        SVPWM_ALIGN_MOD > 1000u) return Fail();
    Delay_ms(10u); /* SPI2/CS沿用已有配置，补足编码器上电等待。 */
    /* SPI2仍由调用方先执行TLE5012B_BusInit；这里检查每颗编码器。 */
    for (id = 0u; id < 2u; ++id) {
        InitTestStep(id == 0u ? "M1 encoder init" : "M2 encoder init");
        result = TLE5012B_Init(id);
        if (result != TLE_OK) {
            Fail();
            if (init_test_step)
                printf("[ENC M%u] init_result=%d\r\n", (unsigned)(id + 1u), (int)result);
            return 0;
        }
        if (init_test_step) printf("[ENC M%u] init_result=0 (OK)\r\n", (unsigned)(id + 1u));
    }

    /*开始校准机械角度增长方向和电角度增长方向，正式把电角度增长方向作为轮子转动正方向*/
    expected = 150.0f / (float)SVPWM_POLE_PAIRS; /* 7极对数：约12.86机械度 */
    for (id = 0u; id < 2u; ++id) {
        /* 0度记录零点，保持通电直接切90度；中间不Stop、不扫描。 */
        InitTestStep(id == 0u ? "M1 align 0deg" : "M2 align 0deg");
        if (!AlignAndRead(id, 0.0f, &zeros[id])) return 0;
        InitTestStep(id == 0u ? "M1 align 150deg" : "M2 align 150deg");
        if (!AlignAndRead(id, 150.0f, &angle180[id])) return 0;
        if (init_test_step) {
            ia = GPIO_ReadInputData(GPIOA); ib = GPIO_ReadInputData(GPIOB);
            oa = GPIO_ReadOutputData(GPIOA); ob = GPIO_ReadOutputData(GPIOB);
        }
        SVPWM_Stop(id); /* 两次对齐之间不停机；完成90度测量后再停机打印。 */
				delta = angle180[id] - zeros[id];

				if (delta >= 180.0f) delta -= 360.0f;
				if (delta < -180.0f) delta += 360.0f;
				/*上面两个if用于处理如：直接相减：2.86 − 350 = −347.14°
				修正之后：−347.14 + 360 = +12.86°的情况*/
				
        if (init_test_step) {
            printf("[ALIGN M%u] mech0=%.3f mech90=%.3f delta=%.3f expected_abs=%.3fdeg\r\n",
                   (unsigned)(id + 1u), zeros[id], angle180[id], delta, expected);
            PrintInitPins("ALIGN90_BEFORE_STOP", ia, ib, oa, ob);
            printf("[PWM M%u] ARR=%u CCR_A/B/C=%u/%u/%u (last 90deg command)\r\n",
                   (unsigned)(id + 1u), (unsigned)timer[id]->ARR,
                   (unsigned)timer[id]->CCR2, (unsigned)timer[id]->CCR3,
                   (unsigned)timer[id]->CCR4);
        }
        /* 位移大小须在理论值的±10%内，不能把堵转/抖动当成方向。 */
        InitTestStep(id == 0u ? "M1 displacement check" : "M2 displacement check");
        if (fabsf(fabsf(delta) - expected) > expected * 0.10f) return Fail();
        signs[id] = delta > 0.0f ? 1 : -1;
    }

    /* 两路都通过后才发布结果；零点仍是0度矢量下的读数。 */
    encoder_sign[0] = signs[0];
    encoder_sign[1] = signs[1];
    zero_point_1 = zeros[0];
    zero_point_2 = zeros[1];
    first_mechanical_angle = angle180[0];
    second_mechanical_angle = angle180[1];
    electrical1 = Wrap360((float)signs[0] * SVPWM_POLE_PAIRS * (angle180[0] - zeros[0]));
    electrical2 = Wrap360((float)signs[1] * SVPWM_POLE_PAIRS * (angle180[1] - zeros[1]));
    calibrated = 1u;/*设置已校准标记，这里的校准表示：电角度和机械角度方向已经用正负符号统一，ADC和DRV8323的校准程序也已经完全成功执行*/
    return 1;
}

int Motor_InitTest(void)
{
    int result;
    printf("=== Motor initialization test: one shot ===\n");
    printf("ALIGN_MOD=%u/1000 POLE_PAIRS=%u PWM=%luHz VDDA_config=%.3fV\n",
           (unsigned)SVPWM_ALIGN_MOD, (unsigned)SVPWM_POLE_PAIRS,
           (unsigned long)SVPWM_PWM_HZ, CURRENT_SENSE_VDDA_V);
    printf("INL=000 during ADC calibration; 111 only during motor alignment.\n");
    init_test_step = "start";/*测试点标记设置开始*/
    result = Motor_init();
    init_test_step = 0;
    SVPWM_Stop(0u);
    SVPWM_Stop(1u);
    if (result) {
        printf("[RESULT M1] zero=%.3fdeg encoder_sign=%d electrical90=%.3fdeg\n",
               zero_point_1, (int)encoder_sign[0], electrical1);
        printf("[RESULT M2] zero=%.3fdeg encoder_sign=%d electrical90=%.3fdeg\n",
               zero_point_2, (int)encoder_sign[1], electrical2);
    }
    PrintInitPins("FINAL_STOP", GPIO_ReadInputData(GPIOA), GPIO_ReadInputData(GPIOB),
                  GPIO_ReadOutputData(GPIOA), GPIO_ReadOutputData(GPIOB));
    printf("=== Motor init %s; INL disabled; no automatic retry ===\n",
           result ? "PASS" : "FAIL");
    return result;
}

/*这个是纯电压环特供，哈哈哈，第一版方案，就是生成一个旋转电压矢量，目前方案已废弃*/
int SVPWM_Update(int8_t dir1, int8_t dir2,
                 uint16_t modulation_1, uint16_t modulation_2)
{
    if (!ready) return 0;
    if (!calibrated || (dir1 != 1 && dir1 != -1) ||
        (dir2 != 1 && dir2 != -1) ||
        modulation_1 > SVPWM_MAX_MOD || modulation_2 > SVPWM_MAX_MOD ||
        !DriverOK()) return Fail();

    /* 停止命令立即执行；正在使用的编码器只尝试一次，失败立即停双路。 */
    if (modulation_1 == 0u) SVPWM_Stop(0u);
    if (modulation_2 == 0u) SVPWM_Stop(1u);
    if ((modulation_1 != 0u &&
         TLE5012B_ReadAngle(0u, &first_mechanical_angle) != TLE_OK) ||
        (modulation_2 != 0u &&
         TLE5012B_ReadAngle(1u, &second_mechanical_angle) != TLE_OK))
        return Fail();

    /* 先读完所需的两路角度，再更新PWM，避免第二路读取失败前更新第一路。 */
    if (modulation_1 != 0u) {
        electrical1 = Wrap360((float)SVPWM_ENCODER_SIGN_1 * SVPWM_POLE_PAIRS *
                             (first_mechanical_angle - zero_point_1));
        if (!SVPWM_Set(0u, electrical1 + (float)dir1 * 90.0f, modulation_1))
            return Fail();
    }
    if (modulation_2 != 0u) {
        electrical2 = Wrap360((float)SVPWM_ENCODER_SIGN_2 * SVPWM_POLE_PAIRS *
                             (second_mechanical_angle - zero_point_2));
        if (!SVPWM_Set(1u, electrical2 + (float)dir2 * 90.0f, modulation_2))
            return Fail();
    }
    return 1;
}



/* 正式电流环的入口：先关两轮，再将TIM2/TIM4从零同步启动。
 * TIM2_CH1只产生内部OC1REF，不输出到PA0；PA0仍是DRV的EN。
 * ADC两rank总耗时=(28.5+12.5)*2=82个ADC时钟。
 * 在计数峰值前半个转换时长触发，使整个序列位于共同低侧窗口中央。 
 * 
 * 下管同时导通，才真正有电流流过采样电阻，否则是没有电流流过采样电阻的
 * 这个时候测量电流，无意义
 * 
 * 这里还利用电感的续流特性*/
int SVPWM_StartCurrent(uint32_t guard_us, float *voltage_ratio)
{
    RCC_ClocksTypeDef clocks;
    TIM_OCInitTypeDef oc;
    uint32_t tim_hz, adc_hz, half_sequence, guard, wait;
    if (!ready || !calibrated || !DriverOK()) return 0;
    SVPWM_Stop(0u); SVPWM_Stop(1u);/*先给电机停机了*/

    /*我们特别提及一点：这两个定时器的时钟源的时钟频率都是HCLK的频率*/
    RCC_GetClocksFreq(&clocks);
    tim_hz = clocks.PCLK1_Frequency;/*得到cpu时钟频率*/
    if (clocks.PCLK1_Frequency != clocks.HCLK_Frequency) tim_hz *= 2u;
    adc_hz = clocks.ADCCLK_Frequency;/*得到ADC的工作频率，这里按照之前的配置貌似是12Mhz*/

    if (adc_hz == 0u || guard_us > 20u) return 0;
    half_sequence = (41u * tim_hz + adc_hz - 1u) / adc_hz;
    /*一个通道：28.5 个采样周期 + 12.5 个转换周期 = 41 个 ADC 时钟
    每个 ADC 连续转换两个通道：41 × 2 = 82 个 ADC 时钟
    半个序列：82 ÷ 2 = 41 个 ADC 时钟
    我们这里就是说ADC转换这么多数据对应的时间，换算成定时器的计数值是多少(定时器的时钟和HCLK是一样的！一个时钟记一个数)
    
    时标记2026-10-26，可以对应去查找对应AI资料和文档资料
    
    这些都是对ADC的配置决定的
    
    这儿的+adc_hz-1 也是为了保障向上取整 如：(3+ 9 -1)/9 ，3/9原本是0，但是加了9-1 就是 11/9就是1了*/


    guard = (tim_hz / 1000000u) * guard_us + 8u; /* 含定时器同步的数拍延迟，这里算是一个裕量吧 */
    if (half_sequence + guard >= period) return 0;
    current_compare_limit = (uint16_t)(period - half_sequence - guard);/*此处就是触发ADC采样的的位置*/
    *voltage_ratio = (float)current_compare_limit / period;/*这里卡死比例主要是为了防止占空比到百分之百，占空比一旦到达百分百或者没预留够采用时间窗口，无法保障下管的有效导通
    电流采样很可能出错，所以，可以说，这是允许的最大的占空比了*/

    TIM_Cmd(TIM2, DISABLE);
    TIM_Cmd(TIM4, DISABLE);

    /*先退出从模式*/
    /*SMCR：定时器的从模式控制寄存器。
        SMS：其中的 bit 2～bit 0，用来选择从模式。
        全部为0，就退出从模式了，这里就是全部清零的*/
    TIM4->SMCR &= ~TIM_SMCR_SMS;
    

    TIM_SelectOutputTrigger(TIM2, TIM_TRGOSource_Enable);/*用于两个定时器同步计数用的，TIM2被使能，则硬件通知TIM4同步启动计数*/
    TIM_OCStructInit(&oc);
    oc.TIM_OCMode = TIM_OCMode_PWM2;
    oc.TIM_OutputState = TIM_OutputState_Disable;/*不会把波形输出到引脚*/
    oc.TIM_Pulse = (uint16_t)(period - half_sequence);/*这个输出PWM(未到引脚)的上升沿通知采样*/


    TIM_OC1Init(TIM2, &oc);
    TIM_OC1PreloadConfig(TIM2, TIM_OCPreload_Enable);/*预装载寄存器*/

    TIM_SetCompare2(TIM2, 0u); TIM_SetCompare3(TIM2, 0u); TIM_SetCompare4(TIM2, 0u);
    TIM_SetCompare2(TIM4, 0u); TIM_SetCompare3(TIM4, 0u); TIM_SetCompare4(TIM4, 0u);
    /*CH2、CH3、CH4 分别控制三相，使用 PWM1、高电平有效模式。
    因此，CCR = 0 表示对应 PWM 输出始终为低。
    不过，此时电机还没有进入“三个下管导通”状态，因为 INL 仍然为低，DRV 依然把上下管全部关闭。
    另外，CCR 已启用预装载，所以这里先写入的是待生效值，后面的更新事件会让这些零值真正生效。*/


    /* 强制从向上计数的0开始；UG只在两轮已高阻时发出。 */
    TIM2->CR1 &= ~(TIM_CR1_CMS | TIM_CR1_DIR);
    TIM4->CR1 &= ~(TIM_CR1_CMS | TIM_CR1_DIR);
    TIM2->CR1 |= TIM_CounterMode_CenterAligned1;
    TIM4->CR1 |= TIM_CounterMode_CenterAligned1;
    /*前两句清除旧的中心对齐设置和方向位，然后后两句重新设为中心对齐模式1。
    目的是避免定时器上一次停止时正处于向下计数阶段，确保这次从预定方向开始
    
    | 字段 | 作用 |
    |------|-----|
    | `CMS` | 选择边沿对齐或中心对齐模式 |
    | `DIR` | 计数方向，0 为向上，1 为向下 |
    */

    TIM_GenerateEvent(TIM2, TIM_EventSource_Update);
    TIM_GenerateEvent(TIM4, TIM_EventSource_Update);
    /*这两句通过软件产生更新事件，也就是设置 UG。
    它会让预装载的 ARR、CCR 等值装入实际使用的寄存器，并重新初始化相关计数状态，包括预分频计数器。*/

    /*计数清零*/
    TIM_SetCounter(TIM2, 0u);
    TIM_SetCounter(TIM4, 0u);
    TIM_SelectInputTrigger(TIM4, TIM_TS_ITR1); /* TIM4的ITR1连接TIM2 */
    TIM_SelectSlaveMode(TIM4, TIM_SlaveMode_Trigger);
    TIM_Cmd(TIM2, ENABLE); /* TRGO=CEN，硬件同时启动TIM4 */
    wait = 10000u;
    while ((TIM4->CR1 & TIM_CR1_CEN) == 0u)/*等待TIM4启动，其实应该是一瞬间同时启动*/
        if (--wait == 0u) return Fail();
    
    TIM4->SMCR &= ~TIM_SMCR_SMS; /* 退出从模式，正常运行，继续计数，只需同步启动，不要每次采样都复位计数器 */
    TIM_SelectOutputTrigger(TIM2, TIM_TRGOSource_OC1Ref);/*这个就是输出就是去给ADC的了，需要框图的话，去看：https://blog.csdn.net/m0_61685198/article/details/137557568*/
    PhaseEnable(0u, Bit_SET); PhaseEnable(1u, Bit_SET);/*使能DRV芯片，正式开始运行电机*/
    running[0] = running[1] = 1u; /* 三相占空比0：全低侧零矢量，不是高阻 */
    return 1;
}

/*这个函数就是通过编码器读取角度的*/
int SVPWM_ReadRotor(uint8_t id, float *mechanical_deg, float *electrical_deg)
{
    float mechanical, zero;
    if (!ready || !calibrated || id > 1u || !DriverOK()) return 0;
    if (TLE5012B_ReadAngle(id, &mechanical) != TLE_OK) return Fail();
    zero = id == 0u ? zero_point_1 : zero_point_2;
    *mechanical_deg = mechanical;
    /* 先转float，避免负方向与无符号极对数相乘后变成巨大正数。 */
    *electrical_deg = Wrap360((float)encoder_sign[id] * SVPWM_POLE_PAIRS * (mechanical - zero));


    /*给记录转子电角度和机械角度的全局变量赋值*/
    if (id == 0u) { first_mechanical_angle = mechanical; electrical1 = *electrical_deg; }
    else { second_mechanical_angle = mechanical; electrical2 = *electrical_deg; }
    return 1;
}

/* 用相同的公共偏移把最小占空比移至0，不改变三相线电压。
 * 相比对称零矢量分配，这样把可用零矢量时间留给低侧采样。
 * PI已按current_compare_limit/period限制电压，不能再额外缩放其输出。 */
int SVPWM_WriteVoltage(uint8_t id, float alpha_v, float beta_v, float bus_v)
{
    float a, b, c, minimum;
    uint16_t ca, cb, cc;
    TIM_TypeDef *tim;
    /*日常一大堆参数校验，确保输入参数的有效性与系统运行状态正常与系统已经初始化了*/
    if (!ready || !calibrated || id > 1u || !running[id] ||
        current_compare_limit == 0u || !DriverOK() || !(bus_v > 0.0f) ||
        !isfinite(bus_v) || !isfinite(alpha_v) || !isfinite(beta_v)) return Fail();

        
    a = alpha_v / bus_v;
    b = (-0.5f * alpha_v + 0.86602540378f * beta_v) / bus_v;
    c = (-0.5f * alpha_v - 0.86602540378f * beta_v) / bus_v;
    minimum = fminf(a, fminf(b, c));
    a -= minimum; b -= minimum; c -= minimum;
    
    /*理论上得到的没加偏置的a，b，c也是不会超过根号三分之一乘voltage_ration的，但加了偏置就不一定了，比如偏置是-0.5 原本的最大的是0.5，那么加了偏置得到的占空比就是1了，
    当然，这种情况其实咋洗三相情况下不可能发生，计算后其实两相最大差值就是voltage_ration*/
    if (fmaxf(a, fmaxf(b, c)) > (float)current_compare_limit / period + 0.00001f)
        return Fail();
    
    /*把得到的占空比转化为真实的计数值*/
    ca = Compare(a); cb = Compare(b); cc = Compare(c);
    /* 仅吸收舍入导致的1个计数误差，不能突破ADC窗口。 Compare函数里有四舍五入操作 */
    if (ca > current_compare_limit) ca = current_compare_limit;
    if (cb > current_compare_limit) cb = current_compare_limit;
    if (cc > current_compare_limit) cc = current_compare_limit;
    tim = timer[id];
    TIM_UpdateDisableConfig(tim, ENABLE);
    TIM_SetCompare2(tim, ca); TIM_SetCompare3(tim, cb); TIM_SetCompare4(tim, cc);
    TIM_UpdateDisableConfig(tim, DISABLE);
    return 1;
}
