xiaotianandbaihui-svg/Graduation_Design/Motor_Driver_KEIL/SVPWM/Hardware/current_sense.c

#include "current_sense.h"
#include "stm32f10x.h"
#include "cycle_counter.h"
#include "stm32f10x_adc.h"
#include "stm32f10x_gpio.h"
#include "stm32f10x_rcc.h"
#include "Delay.h"

#define ADC_WAIT_LIMIT       10000u  /* 有限轮询次数，非精确微秒，这里只是做了一个最简单的超时检测*/
#define ZERO_SAMPLES         32u
#define ZERO_TOL_COUNTS      256.0f  /* 零点应接近半量程，拒绝掉电/明显接线异常 */
#define CAL_HOLD_US          200u    /* DRV8323自动校准要求至少100us */
#define ADC_VOLTS_PER_COUNT  (CURRENT_SENSE_VDDA_V / 4096.0f)

static uint8_t ready;/*用于判断ADC启动状态的全局变量*/
static float zero_a[2], zero_b[2];/*电机零点的原始数值采取*/
static const char *last_error = "none";

const char *CurrentSense_GetLastError(void) { return last_error; }

static int DriverActive(void)/*这边主要就是确认那两个DRV8323是否正常工作的*/
{
    return GPIO_ReadOutputDataBit(GPIOA, GPIO_Pin_0) == Bit_SET &&/*已经使能，对应EN*/
           GPIO_ReadOutputDataBit(GPIOB, GPIO_Pin_4) == Bit_RESET &&/*这个引脚是CAL，用于DRV8323的校准，低电平表示当前未请求校准*/
           GPIO_ReadInputDataBit(GPIOA, GPIO_Pin_8) == Bit_SET &&/*对应DRV8323芯片的nFAULT*/
           GPIO_ReadInputDataBit(GPIOB, GPIO_Pin_5) == Bit_SET;/*对应DRV8323芯片的nFAULT*/
}

static int Fail(void)
{
    ready = 0u;
    ADC_Cmd(ADC1, DISABLE);
    ADC_Cmd(ADC2, DISABLE);
    return 0;
}

static int CalibrateADC(ADC_TypeDef *adc)/*ADC校准程序*/
{
    uint32_t wait = ADC_WAIT_LIMIT;
    ADC_ResetCalibration(adc);
    while (ADC_GetResetCalibrationStatus(adc) != RESET)
        if (--wait == 0u) return 0;
    ADC_StartCalibration(adc);
    wait = ADC_WAIT_LIMIT;
    while (ADC_GetCalibrationStatus(adc) != RESET)
        if (--wait == 0u) return 0;
    return 1;
}

int CurrentSense_ReadRaw(CurrentSense_Raw *raw)
{
    CurrentSense_Raw sample;
    uint32_t wait = ADC_WAIT_LIMIT;
    if (!ready || raw == 0 || !DriverActive()) return 0;
    ADC_ClearFlag(ADC1, ADC_FLAG_JEOC);
    ADC_ClearFlag(ADC2, ADC_FLAG_JEOC);
    ADC_ExternalTrigInjectedConvConfig(ADC1, ADC_ExternalTrigInjecConv_None);/*重复配置，保险*/
    ADC_SoftwareStartInjectedConvCmd(ADC1, ENABLE); /* ADC1触发双ADC ，这里会打开触发使能的(外部)，其实软件触发的信号也要过这个位使能*/
    while (ADC_GetFlagStatus(ADC1, ADC_FLAG_JEOC) == RESET ||
           ADC_GetFlagStatus(ADC2, ADC_FLAG_JEOC) == RESET)
        if (--wait == 0u) return Fail();/*等待转化完成*/
    sample.a[0] = ADC_GetInjectedConversionValue(ADC1, ADC_InjectedChannel_1);
    sample.b[0] = ADC_GetInjectedConversionValue(ADC2, ADC_InjectedChannel_1);
    sample.a[1] = ADC_GetInjectedConversionValue(ADC1, ADC_InjectedChannel_2);
    sample.b[1] = ADC_GetInjectedConversionValue(ADC2, ADC_InjectedChannel_2);
    if (!DriverActive()) return 0;
    *raw = sample;
    return 1;
}

/* TIM2的OC1REF上升沿触发；两轮PWM已同步，并由SVPWM限制占空比保证窗口。
 * 只接收本次使能外触发之后的新序列。DWT由motor_current初始化。 
 
 总的来说：这个函数就是等待下一次合适的 PWM 采样时机，让两个 ADC 同步转换，然后读出两台电机的四路原始电流采样值。
 */
int CurrentSense_ReadSynchronized(CurrentSense_Raw *raw)
{
    uint32_t began = CycleCounter_Now();
    CurrentSense_Raw sample;
    last_error = "none";
    if (!ready || raw == 0) { last_error = "not-ready/argument"; return 0; }
    if (!DriverActive()) { last_error = "driver-inactive"; return 0; }
    ADC_ExternalTrigInjectedConvCmd(ADC1, DISABLE);
    ADC_ExternalTrigInjectedConvConfig(ADC1, ADC_ExternalTrigInjecConv_T2_TRGO);
    ADC_ClearFlag(ADC1, ADC_FLAG_JEOC);
    ADC_ClearFlag(ADC2, ADC_FLAG_JEOC);
    /* 先等OC1REF明确为低，再打开触发；下一次真正的上升沿才开始采样。
     * 留半个CCR1的距离，避免在OC1REF已经为高时使能外部触发。 */
    while (TIM2->CNT >= TIM2->CCR1 / 2u)/*这里的CCR1就是通过ADC配置得到的那个上升沿跳变点*/
        if ((uint32_t)(CycleCounter_Now() - began) > SystemCoreClock / 5000u) {
            last_error = "pwm-window-timeout";
            return Fail();
        }

    ADC_ExternalTrigInjectedConvCmd(ADC1, ENABLE);/*开启触发，等待转化完成*/
    while (ADC_GetFlagStatus(ADC1, ADC_FLAG_JEOC) == RESET ||
           ADC_GetFlagStatus(ADC2, ADC_FLAG_JEOC) == RESET) {
        if ((uint32_t)(CycleCounter_Now() - began) > SystemCoreClock / 5000u) {
            ADC_ExternalTrigInjectedConvCmd(ADC1, DISABLE); /* 最多等待200us */
            last_error = "adc-conversion-timeout";
            return Fail();
        }
    }/*只等待200us*/

    ADC_ExternalTrigInjectedConvCmd(ADC1, DISABLE);
    sample.a[0] = ADC_GetInjectedConversionValue(ADC1, ADC_InjectedChannel_1);
    sample.b[0] = ADC_GetInjectedConversionValue(ADC2, ADC_InjectedChannel_1);
    sample.a[1] = ADC_GetInjectedConversionValue(ADC1, ADC_InjectedChannel_2);
    sample.b[1] = ADC_GetInjectedConversionValue(ADC2, ADC_InjectedChannel_2);
    if (!DriverActive()) { last_error = "driver-inactive"; return 0; }
    *raw = sample;
    return 1;
}

/*下面这个函数会上电就采样ZERO_SAMPLES次，获得零点偏移量(这个零偏是直接从ADC读出来的原始数据哦)，这个函数会被SVPWM_Init函数调用*/
int CurrentSense_Init(void)
{
    GPIO_InitTypeDef gpio;
    ADC_InitTypeDef adc;
    CurrentSense_Raw raw;
    uint32_t sum_a[2] = {0u, 0u}, sum_b[2] = {0u, 0u};
    uint8_t i, id;
    ready = 0u;
    /* 只在驱动初始化的高阻阶段调用；不替调用方切换电机输出状态。 */
    if (!DriverActive() ||
        (GPIO_ReadOutputData(GPIOB) & (GPIO_Pin_12 | GPIO_Pin_11 | GPIO_Pin_10 |
                                     GPIO_Pin_6 | GPIO_Pin_3)) != 0u ||
        GPIO_ReadOutputDataBit(GPIOA, GPIO_Pin_15) != Bit_RESET) return 0;

    RCC_APB2PeriphClockCmd(RCC_APB2Periph_GPIOA | RCC_APB2Periph_GPIOB |
                          RCC_APB2Periph_ADC1 | RCC_APB2Periph_ADC2, ENABLE);


    RCC_ADCCLKConfig(RCC_PCLK2_Div6); /* 72MHz系统时为12MHz，不超过14MHz */
    gpio.GPIO_Mode = GPIO_Mode_AIN;
    gpio.GPIO_Speed = GPIO_Speed_50MHz;
    gpio.GPIO_Pin = GPIO_Pin_5 | GPIO_Pin_6 | GPIO_Pin_7;
    GPIO_Init(GPIOA, &gpio);
    gpio.GPIO_Pin = GPIO_Pin_0;
    GPIO_Init(GPIOB, &gpio);

    ADC_DeInit(ADC1);
    ADC_DeInit(ADC2);
    ADC_StructInit(&adc);
    adc.ADC_ScanConvMode = ENABLE;
    adc.ADC_ContinuousConvMode = DISABLE;
    adc.ADC_ExternalTrigConv = ADC_ExternalTrigConv_None;
    adc.ADC_DataAlign = ADC_DataAlign_Right;
    adc.ADC_NbrOfChannel = 1u; /* 不启动规则组；下面单独设置注入组长度 */
    adc.ADC_Mode = ADC_Mode_Independent;
    ADC_Init(ADC2, &adc);
    adc.ADC_Mode = ADC_Mode_InjecSimult;
    ADC_Init(ADC1, &adc);
    ADC_InjectedSequencerLengthConfig(ADC1, 2u);
    ADC_InjectedSequencerLengthConfig(ADC2, 2u);
    ADC_InjectedChannelConfig(ADC1, ADC_Channel_5, 1u, ADC_SampleTime_28Cycles5);
    ADC_InjectedChannelConfig(ADC2, ADC_Channel_6, 1u, ADC_SampleTime_28Cycles5);
    ADC_InjectedChannelConfig(ADC1, ADC_Channel_7, 2u, ADC_SampleTime_28Cycles5);
    ADC_InjectedChannelConfig(ADC2, ADC_Channel_8, 2u, ADC_SampleTime_28Cycles5);
    ADC_ExternalTrigInjectedConvConfig(ADC1, ADC_ExternalTrigInjecConv_None);/*这里虽然是先配置为了软件触发，但是后面会改的QAQ*/
    ADC_ExternalTrigInjectedConvConfig(ADC2, ADC_ExternalTrigInjecConv_None);
    ADC_ExternalTrigInjectedConvCmd(ADC2, ENABLE);/*这里不调用ADC1，把外部触发使能是因为：后面触发转化调用函数ADC_SoftwareStartInjectedConvCmd(ADC1, ENABLE)的时候
    这个函数自带使能外部触发的效果，一次性设置触发使能+触发转化 */
    ADC_Cmd(ADC1, ENABLE);
    ADC_Cmd(ADC2, ENABLE);
    Delay_us(10u); /* 上电稳定后才能启动ADC校准 ，等待上电稳定*/
    if (!CalibrateADC(ADC1) || !CalibrateADC(ADC2)) return Fail();

    /* 此时六个外部MOS均不切换；CAL期间增益临时变为40倍，不能在此时
     * 保存20倍正常工作时的零偏。拉低CAL、恢复正常增益后再采样。 */
    GPIO_SetBits(GPIOB, GPIO_Pin_4);/*拉高校准*/
    Delay_us(CAL_HOLD_US);/*等待校准完成，这个手册是至少100us*/
    GPIO_ResetBits(GPIOB, GPIO_Pin_4);/*拉低，校准完成*/
    Delay_us(20u);
    ready = 1u;/*准备就绪完成*/


    /*开始采样，得到零偏电压值（DRV是正负电流都有的，这个基准值还是很重要的）*/
    for (i = 0u; i < ZERO_SAMPLES; ++i) {
        if (!CurrentSense_ReadRaw(&raw)) return Fail();
        for (id = 0u; id < 2u; ++id) {
            sum_a[id] += raw.a[id];
            sum_b[id] += raw.b[id];
        }
    }
    for (id = 0u; id < 2u; ++id) {
        float a = (float)sum_a[id] / ZERO_SAMPLES;
        float b = (float)sum_b[id] / ZERO_SAMPLES;
        if (a < 2048.0f - ZERO_TOL_COUNTS || a > 2048.0f + ZERO_TOL_COUNTS ||
            b < 2048.0f - ZERO_TOL_COUNTS || b > 2048.0f + ZERO_TOL_COUNTS)/*这个ZERO_TOL_COUNTS是零偏容差*/
            return Fail();
        zero_a[id] = a;
        zero_b[id] = b;
    }
    return 1;
}

int CurrentSense_GetZero(uint8_t id, float *a, float *b)
{
    if (!ready || id > 1u || a == 0 || b == 0) return 0;
    *a = zero_a[id];
    *b = zero_b[id];
    return 1;
}

float va,vb;
/*把电压转化为电流*/
int CurrentSense_Convert(uint8_t id, const CurrentSense_Raw *raw,
                         CurrentSense_Phase *current)
{
    CurrentSense_Phase result;
    const float scale = ADC_VOLTS_PER_COUNT /
                        (CURRENT_SENSE_GAIN * CURRENT_SENSE_SHUNT_OHM);
    last_error = "none";
    if (!ready || id > 1u || raw == 0 || current == 0) {
        last_error = "not-ready/argument";
        return 0;
    }
    va = raw->a[id] * ADC_VOLTS_PER_COUNT;
    vb = raw->b[id] * ADC_VOLTS_PER_COUNT;
		
    /* 取0.3V余量，超量程直接报错，不把被削顶的值当真实电流。 */
    if (va <= 0.3f || va >= CURRENT_SENSE_VDDA_V - 0.3f ||
        vb <= 0.3f || vb >= CURRENT_SENSE_VDDA_V - 0.3f) {
        last_error = "adc-out-of-range";
        return 0;
    }
				
    /* 正方向：星点经绕组流向逆变器；与原流入电机的定义相反。 */
    result.ia_a = (zero_a[id] - (float)raw->a[id]) * scale;
    result.ib_a = (zero_b[id] - (float)raw->b[id]) * scale;
    result.ic_a = -result.ia_a - result.ib_a;
		
    *current = result;
    return 1;
}
