xiaotianandbaihui-svg/Graduation_Design/Remote_Controller/My_Remote_Controller/USER/remote_font.c

/* Generated LVGL 4bpp font subsets for remote_ui and remote_dashboard. */
#include "remote_font.h"
static const uint8_t remote_font_20_bitmap[] = {
    0x00,0xef,0x10,0x00,0xdf,0x10,0x00,0xdf,0x10,0x00,0xdf,0x00,0x00,0xcf,0x00,0x00,0xcf,0x00,0x00,0xce,0x00,0x00,0xbe,0x00,
    0x00,0xbe,0x00,0x00,0xbd,0x00,0x00,0x00,0x00,0x00,0x00,0x00,0x00,0x45,0x00,0x01,0xff,0x40,0x00,0xcd,0x20,0x00,0xdf,0x4f,
    0x90,0x00,0x0d,0xe3,0xf8,0x00,0x00,0xcd,0x2f,0x70,0x00,0x0b,0xc1,0xf7,0x00,0x00,0xab,0x0f,0x60,0x00,0x00,0x00,0x00,0x00,
    0x00,0x00,0x00,0x00,0x00,0x00,0x00,0x00,0x00,0x00,0x00,0x00,0x00,0x00,0x00,0x00,0x00,0x00,0x00,0x00,0x00,0x00,0x00,0x00,
    0x00,0x00,0x00,0x00,0x00,0x00,0x00,0x00,0x00,0x00,0x00,0x00,0x00,0x00,0x00,0x00,0x00,0x00,0x00,0x1f,0x50,0x1f,0x50,0x00,
    0x00,0x04,0xf2,0x04,0xf2,0x00,0x00,0x00,0x8e,0x00,0x7e,0x00,0x00,0x00,0x0b,0xb0,0x0b,0xb0,0x00,0x0c,0xff,0xff,0xff,0xff,
    0xff,0x30,0x33,0x5f,0x63,0x5f,0x63,0x30,0x00,0x06,0xf1,0x05,0xf1,0x00,0x00,0x00,0x9c,0x00,0x9d,0x00,0x00,0x8f,0xff,0xff,
    0xff,0xff,0xf7,0x02,0x34,0xf7,0x33,0xf8,0x33,0x10,0x00,0x3f,0x30,0x3f,0x30,0x00,0x00,0x06,0xf0,0x06,0xf1,0x00,0x00,0x00,
    0x9d,0x00,0x9d,0x00,0x00,0x00,0x0b,0xa0,0x0b,0xa0,0x00,0x00,0x00,0x00,0x00,0x00,0x00,0x00,0x00,0x00,0x00,0x09,0x80,0x00,
    0x00,0x00,0x00,0x09,0x80,0x00,0x00,0x00,0x03,0xae,0xfd,0x70,0x00,0x00,0x5f,0xed,0xdc,0xf6,0x00,0x01,0xee,0x29,0x80,0x57,
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
    .kern_dsc=NULL, .kern_scale=0, .cmap_num=1, .bpp=4, .kern_classes=0, .bitmap_format=0
};
const lv_font_t remote_digits_72 = {
    .get_glyph_dsc=lv_font_get_glyph_dsc_fmt_txt, .get_glyph_bitmap=lv_font_get_bitmap_fmt_txt,
    .line_height=90, .base_line=18, .subpx=LV_FONT_SUBPX_NONE,
    .underline_position=-2, .underline_thickness=1, .dsc=&remote_digits_72_descriptor, .fallback=NULL
};
