xiaotianandbaihui-svg/Graduation_Design/Remote_Controller/My_Remote_Controller/USER/remote_font.h

#ifndef REMOTE_FONT_H
#define REMOTE_FONT_H
#include "lvgl.h"
LV_FONT_DECLARE(remote_font_20);
LV_FONT_DECLARE(remote_font_24);
LV_FONT_DECLARE(remote_digits_48);
LV_FONT_DECLARE(remote_digits_72);
#endif
