xiaotianandbaihui-svg/Graduation_Design/Motor_Driver_KEIL/SVPWM/Hardware/can_pitch.h

#ifndef MOTOR_CAN_PITCH_H
#define MOTOR_CAN_PITCH_H

#include <stdint.h>

/* 模式切换单独握手；暂停确认之后，跳跃期间不再发送周期控制帧。跳跃模式特供 */
#define CAN_DRIVE_MODE_ID      0x102u
#define CAN_DRIVE_MODE_ACK_ID  0x201u

#define CAN_DRIVE_NONE        0u
#define CAN_DRIVE_PAUSE       1u
#define CAN_DRIVE_RESUME      2u
/*--------------------------------------------------------*/

extern volatile uint8_t CAN_DriveCommand;
int CAN_SendDriveModeAck(uint8_t mode);


/* 电驱端：STM32F103C8T6，PA11=RX、PA12=TX，500 kbit/s。 */
#define CAN_ANGLE_LEGHEIGHT_ID 0x101u  /* 主控 -> 电驱 */
#define CAN_TARGET_ANGLE_ID 0x100u
#define CAN_SPEED_ID    0x200u
/* 本模块定义这两个变量，main.c不要重复定义。
 * 同一报文更新[0]=Pitch、[1]=Yaw；电驱端不保存Roll，单位度。 */

/* 在系统时钟初始化之后调用；1成功，0时钟不支持或CAN初始化失败。
 * 独占CAN1和滤波器0，不配置系统时钟、不使用定时器。 */
int CAN_Init_Together(void);

/* 一帧回传Pitch、Yaw：两个int16，小端，单位0.01度，共4字节。
 * 每轴输入范围[-327.68,327.67]度，四舍五入至0.01度。
 * 1已提交发送邮箱；0邮箱忙、输入非有限或超范围。
 * 返回1不代表对方已经收到；不等待发送完成。 */
int CAN_Angle_and_LegHeight_Send(float pitch_deg, float yaw_deg,float left_leg_height,float right_leg_height);
int CAN_Send_The_Wheels_Speed(float* left_rpm ,float* right_rpm);

#endif
