xiaotianandbaihui-svg/Graduation_Design/固件代码(非KEIL工程)/跳跃动作/板三_TIM4_裸机例程/jump_tick.c

#include "jump_tick.h"
#include "stm32f10x.h"
#include "stm32f10x_rcc.h"
#include "stm32f10x_tim.h"

uint8_t JumpTick_Init(void)
{
    TIM_TimeBaseInitTypeDef base;

    RCC_APB1PeriphClockCmd(RCC_APB1Periph_TIM4, ENABLE);
    TIM_DeInit(TIM4);
    TIM_TimeBaseStructInit(&base);
    base.TIM_Prescaler = 7200u - 1u;             /* 当前TIM4输入72MHz，计数10kHz */
    base.TIM_Period = 65535u;                    /* 每次加1为0.1ms */
    base.TIM_CounterMode = TIM_CounterMode_Up;
    base.TIM_ClockDivision = TIM_CKD_DIV1;
    TIM_TimeBaseInit(TIM4, &base);

    JumpTick_Stop(); /* 配置后保持停止，等Jump_Start成功才开始计时 */
    return 1;
}

void JumpTick_Start(void)
{
    JumpTick_Stop();
    TIM_Cmd(TIM4, ENABLE);
}

void JumpTick_Stop(void)
{
    TIM_Cmd(TIM4, DISABLE);
    /* 向上计数时UG将CNT及预分频内部计数清零、装载PSC/ARR配置。
     * 不是把ARR=65535复制给CNT。UG也会置更新标志，因此随后清除。
     */
    TIM_GenerateEvent(TIM4, TIM_EventSource_Update);
    TIM_ClearFlag(TIM4, TIM_FLAG_Update);
}

uint32_t JumpTick_Millis(void)
{
    uint16_t count = TIM_GetCounter(TIM4);
    /* 先读CNT再检查标志，捕获恰好在读取过程中发生的溢出。
     * 未开启中断，UIF仍会在溢出后置位，并保留到主动清除。
     */
    if (TIM_GetFlagStatus(TIM4, TIM_FLAG_Update) != RESET) return JUMP_TICK_EXPIRED;
    return (uint32_t)count / 10u;
}
