xiaotianandbaihui-svg/Graduation_Design/(notices)

Notices in the files:
Remote_Controller/My_Remote_Controller/HARDWARE/TOUCH/ft5206.c:
Copyright(C) ¹ãÖÝÊÐÐÇÒíµç×Ó¿Æ¼¼ÓÐÏÞ¹«Ë¾ 2014-2024
All rights reserved
Remote_Controller/My_Remote_Controller/SYSTEM/usart/usart.h:
Copyright(C) ÕýµãÔ­×Ó 2009-2019
